mritunjaysharma450-cloud/VISHVAKARMA-AWARDS-VK26-IITH-SC-0177/Maker Journey/WhatsApp Image 2026-10-26 at 10.41.54 PM.jpeg

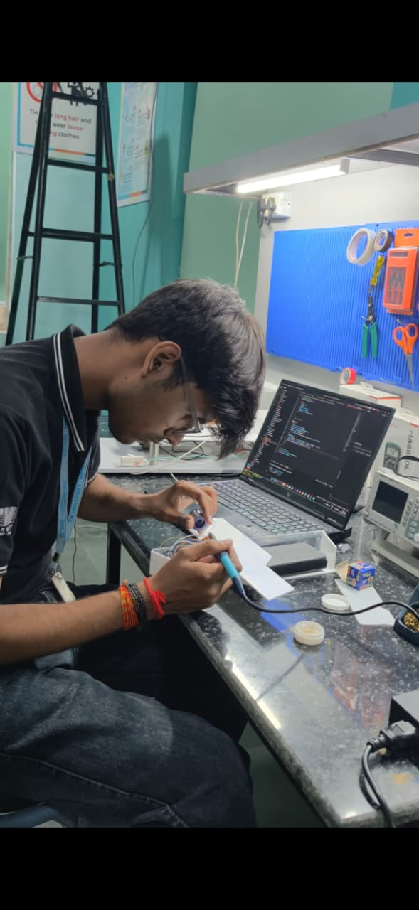
Maker Journey/WhatsApp Image 2026-10-26 at 10.41.54 PM.jpeg
