mritunjaysharma450-cloud/VISHVAKARMA-AWARDS-VK26-IITH-SC-0177/CAD Design & Mechanical Specs/CAD-Design-and-Mechanical-Specs.md

# CAD Design & Mechanical Specs

This section contains design intent only. CAD files are not included
in this version, and FEA has not been performed.

- Pole height, as in the submitted deck: about 2 m, concept stage.
- Pole material, as in the submitted deck: PVC / GI under consideration.
  No material is claimed as selected, and no material property is
  claimed as tested.
- Enclosures: to be made after measuring components and PCB, as in
  the deck. No enclosure design is presented here.
- CAD files: the deck states "CAD file will be updated later in the
  github repo". That update has not been made yet. This folder is
  therefore a placeholder for CAD work, not a CAD delivery, and it
  contains no CAD renders, exploded views, or STEP / SLDPRT files.
- FEA / stress analysis: NOT performed. No FEA plot, mesh statistic,
  convergence result, or load-bearing calculation is presented here.
- Mechanical validation: none performed yet. Bench and closed-course
  mechanical testing is Stage 3 work, as in the roadmap.

The institution template asks for 3D renders, material selection, and
FEA. The position of this section is: CAD and FEA are pending, the pole
concept is about 2 m, and material is under consideration.
