mritunjaysharma450-cloud/VISHVAKARMA-AWARDS-VK26-IITH-SC-0177/INDEX.md

# Contents

Folder names follow the institution template sections, including "&"
where the template uses it. This repository contains supplementary
technical content that was not in the Stage 2 presentation. Material
already presented in the presentation is not repeated here, and sections
with no supplementary content beyond the presentation are not included
as folders.

| No. | Template section | Folder in this repository | Contents | Note |
|---|---|---|---|---|
| 1 | Project Overview | — | Presented in the Stage 2 presentation | — |
| 2 | Problem Statement | — | Presented in the Stage 2 presentation | — |
| 3 | Problem Context | — | Presented in the Stage 2 presentation | — |
| 4 | User Journey | — | Presented in the Stage 2 presentation | — |
| 5 | System Architecture & Specs | System Architecture & Specs/ | Overall-System-Architecture.md, Pole-Unit-Software-Design-Refined.md, Vehicle-Module-Software-Design-Refined.md | Design only, this design has not been bench-tested |
| 6 | CAD Design & Mechanical Specs | CAD Design & Mechanical Specs/ | CAD-Design-and-Mechanical-Specs.md | CAD files are not included in this version, FEA has not been performed |
| 7 | Electronics Schematics & BOM | Electronics Schematics & BOM/ | Pole Unit Electronic Schematic/ (KiCad source, netlist, ERC), Vehicle Module Electronic Schematic/ (KiCad source, netlist, ERC), BOM-Note.md | Schematics are drafts, Rev A, ERC 0/0/0. BOM update is described in BOM-Note.md |
| 8 | Maker Journey | Maker Journey/ | README.md with photo captions | Joint mentor photo is not included in this version |
| 9 | Safety & Hazard Mitigation | Safety & Hazard Mitigation/ | Safety-and-Failure-Modes.md | Design stage |
| 10 | Roadmap | — | Presented in the Stage 2 presentation | — |
| 11 | Technical Challenges & Risks | Technical Challenges & Risks/ | Technical-Challenges-and-Risks.md, Latency-and-Power-Budgets.md, Test-Protocols.md (results blank), Theoretical-Stress-Testing-16-Scenarios.md | Theory and protocols only |
| 12 | References & Sources | References & Sources/ | Research-Plan.md (52 papers, direct links) | Design research only |

## Dates
- Schematics: made in KiCad 24 October 2026, revised 26 October 2026
  due to component changes.
- Research plan: papers analyzed before submission (Table A, 38) and
  additional literature found 26 October 2026 during submission
  preparation (Table B, 14, NOT prior use).
- All other files in this repository are October 2026 design work, unless
  a file itself states a different date. No dates have been changed.
