mritunjaysharma450-cloud/VISHVAKARMA-AWARDS-VK26-IITH-SC-0177/System Architecture Block Diagram/System Architecture Block Diagram..pdf

# System Architecture Block Diagram

### Digital Zone Mapping | Roadside Radar-UWB Sensing | Connected Vehicle Control

V-ORRA | Intelligent Vehicle Signalling & Connected Road Safety System | VK26-IITH-SC-0177 | Vishwakarma Awards 2026-27 | ITM University Gwalior | 27 October 2026 preparation

### ZONE MAPPING SOFTWARE

F Zone configuration and authorized deployment

## ROADSIDE POLE UNIT

E Electronic controllers | F Firmware / logic | M Mounting | A Power

## SMART VEHICLE UNIT

E Controllers | F Local validation | M Enclosure | A Auxiliary actuation

### 1 Administrator / Traffic Authority

Authorized system operator

Zone Mapping Application

Surveyed road / carriageway geometry NHZ and LBZ polygons; zone IDs Activation policies and coordinates

Configuration Validation
& Versioning

Boundary and policy checks Integrity; version control Authorized deployment

Define zones

Validate / approve

Configuration boundary

Spatial zones and operating policies are deployed to the pole.

Transfer method remains open. Geofence decisions execute on Pi.

Sustainable Cities
Smart Urban Infrastructure & Asset Tracking

### 2 Texas Instruments AWRL6432BOOST

60 GHz FMCW Radar | 57-64 GHz family
Range | Angle | Doppler | Detections
Nominal azimuth FoV ~120 deg; configuration dependent

M Mechanical Structure
& Mounting

~2 m circular pole; top enclosure Adjustable radar / UWB brackets Weighted base; cable routing / support

### 3 Makerfabs MAUWBS3CA1

UWB Anchor - STM32 / DW3000
Tag ID | UWB Range | Timestamp
Single anchor: distance constraint only

Powered USB Hub

4-port USB 3.0 | USB-A upstream
P1 Radar J5 | P2 Anchor USB-UART
P3 Safety gate USB serial
P4 Reserved | Separate 5 V AUX

USB 2.0 / XDS110 Data + Power

USB Serial / UWB Range Reports - hub P2

### Raspberry Pi 5 - Edge Processing Unit

Model B, 1 GB | Local processing and communications

P1 Radar Acquisition

Firmware-defined detections

P2 UWB Acquisition

Tag range / time / validity

Zone Configuration Store

Approved geometry / policies Version and integrity metadata

Authorized Zone Configuration Deployment

USB-A Host

P3 Sensor Calibration & Time Association

Coordinate transforms; mounting offsets; valid / aligned observations

### 4 Vehicle Tracking & Sensor Association

P4 | Multi-frame tracks; radar position vs UWB range
Track-to-tag matching; motion consistency; ambiguity checks

Associated observations

### 5 Confidence-Aware Geofence Decision

P5 | NHZ / LBZ boundary + track position + uncertainty
CONFIRMED_INSIDE_NHZ / _LBZ | CONFIRMED_OUTSIDE
UNKNOWN or ambiguity: no new restrictive command

Track / identity / confidence

P6 Vehicle-Specific Command Proposal

Provisional state only; USB host / hub P3 to safety gate

Proposed state

### 10 Logging & Diagnostics

P8 | Observations; association
Zone / proposal / gate events Applied-state ACK; faults
Side branch; outside control path

Events

P7 Local Network
& MQTT Broker

Pi-hosted 2.4 GHz Wi-Fi AP Mosquitto MQTT broker

Gate + vehicle are Wi-Fi clients. All MQTT traffic uses this broker.

No Pi bypass of gate approval; return ACK / faults to monitoring.

ACK / faults 6 ESP32-S3
Pole Safety Gate

USB serial proposals via hub P3
ARM / DENY; startup DENY
Proposal / association / confidence Session / freshness / watchdog

All authorization checks must pass. Else deny new restrictions. ARM/DENY input: LOW / HIGH Green gate-status LED

USB Serial Proposals /

Diagnostics

Proposal via hub P3

2.4 GHz Wi-Fi / MQTT | Authorized publication; gate status / ACK

Firmware-controlled authorization subsystem

RF LINK A
UWB Two-Way Ranging

IEEE 802.15.4z-compatible
hardware | range evidence No actuation commands

### Makerfabs bare MaUWB tag

Bare UWB tag | regulated 3.3 V
Tag UART | UWB ranging
Tag identity and ranging participation

A 3.3 V Regulator for UWB Tag

Regulated 3.3 V supply for bare tag Local common ground
Implementation per schematic

3.3 V DC

Optional GPS / GNSS

GPS UART, context only
Never a zone authority

### 8 ESP32-S3 Vehicle Controller

ESP32-S3

Wi-Fi / MQTT Client
Command Validation
Vehicle / tag identity and session Independent gate-authorization checks Authenticity / replay / expiry checks Physical override priority

Vehicle State Machine
Lamp HIGH/LOW mode + strobe
Horn coil command + deadman pulse
Tag UART | GPS UART | override sense
Acknowledgements / Diagnostics Local watchdog and safe recovery

Tag UART - 115200 / 8N1
3.3 V logic; matching firmware
Tag TX to controller RX
Controller TX to tag RX
Local common ground GPS UART

RF LINK B

### 2.4 GHz Wi-Fi / MQTT

7 Authenticated Vehicle-Specific MQTT Command

Applied-State ACK
+ Fault Status

Wireless links only
Independent demo supplies
Local grounds; no cable

### 9 Auxiliary Horn Control

Horn deadman timer + MOSFET driver Fresh pulses required for suppression Expiry / fault / link loss: fail-open release Normally-closed relay: horn available when coil power is lost
Auxiliary demo sounder + horn button

Coil + pulse

Status & Diagnostics

Status indicators | diagnostic alerts
Horn-button sense | applied state / faults

### 9 Auxiliary Lighting Control

Lamp mode latch + MOSFET driver HIGH/LOW auxiliary demo lamp Holds mode on stale / unknown data FREEZE; no automatic HIGH on uncertainty

Mode/strobe

M Mechanical Structure & Mounting

Compact electronics enclosure with mounting provision Secure controller / tag / demo outputs and local cable routing

A Physical Override

Rail cut + relay bypass; wins if firmware hangs Manual HIGH/LOW selection; override sense

A POLE POWER - separate regulated supplies

100 W / 156 Wh

Portable Power Station

Rated AC Extension

Purchased AC connections

AC | Official Raspberry Pi 27 W USB-C Supply

Regulated Adapter

### 5.1 V DC / 5 A to Pi USB-C

Regulated DC to Hub AUX

Active Cooler: official Pi fan connector

A VEHICLE POWER - independent supply / local common GND

Independent Demo

Power Supply

Fuse + Master Switch

Switched demo supply

Demo Power Distribution

Controller | UWB regulator | optional GPS
Auxiliary horn path | physical override input
Override gates actuation; local ground
CONTROL PRINCIPLES | Ambiguous position / identity: no new restriction. | Expired horn authorization: release suppression.
Uncertain lighting: no automatic HIGH. | Physical override has priority. | Auxiliary demo only; closed-course only.
Independent demo supplies; local grounds only; no pole-to-vehicle cable or wiring into real vehicle horn / headlamp circuits.
LINE CONVENTIONS | Arrow direction indicates sender to receiver; matching named power nets are continuous locally.
Wired / logical data | Wireless RF | Power / voltage | Configuration | Inhibit / output control
M Mechanical structure | A Actuation & power | E Electronic controllers | F Firmware & logic | Dashed box: optional feature | SHEET 01 / 03
