mritunjaysharma450-cloud/VISHVAKARMA-AWARDS-VK26-IITH-SC-0177/Maker Journey/IMG_20261023_164714.jpg.jpeg

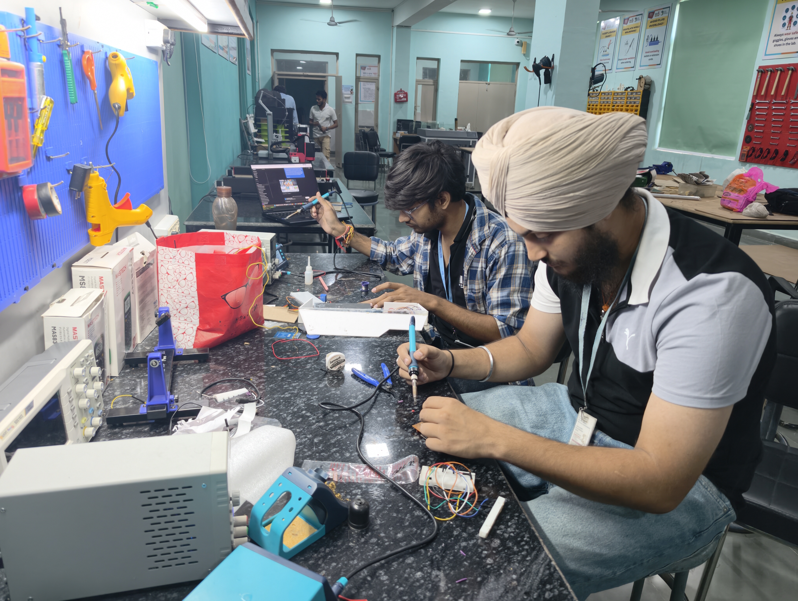
Maker Journey/IMG_20261023_164714.jpg.jpeg
