mritunjaysharma450-cloud/VISHVAKARMA-AWARDS-VK26-IITH-SC-0177/Electronics Schematics & BOM/Vehicle Module Electronic Schematic/Vehicle_Module_Electronic_Schematic.pdf

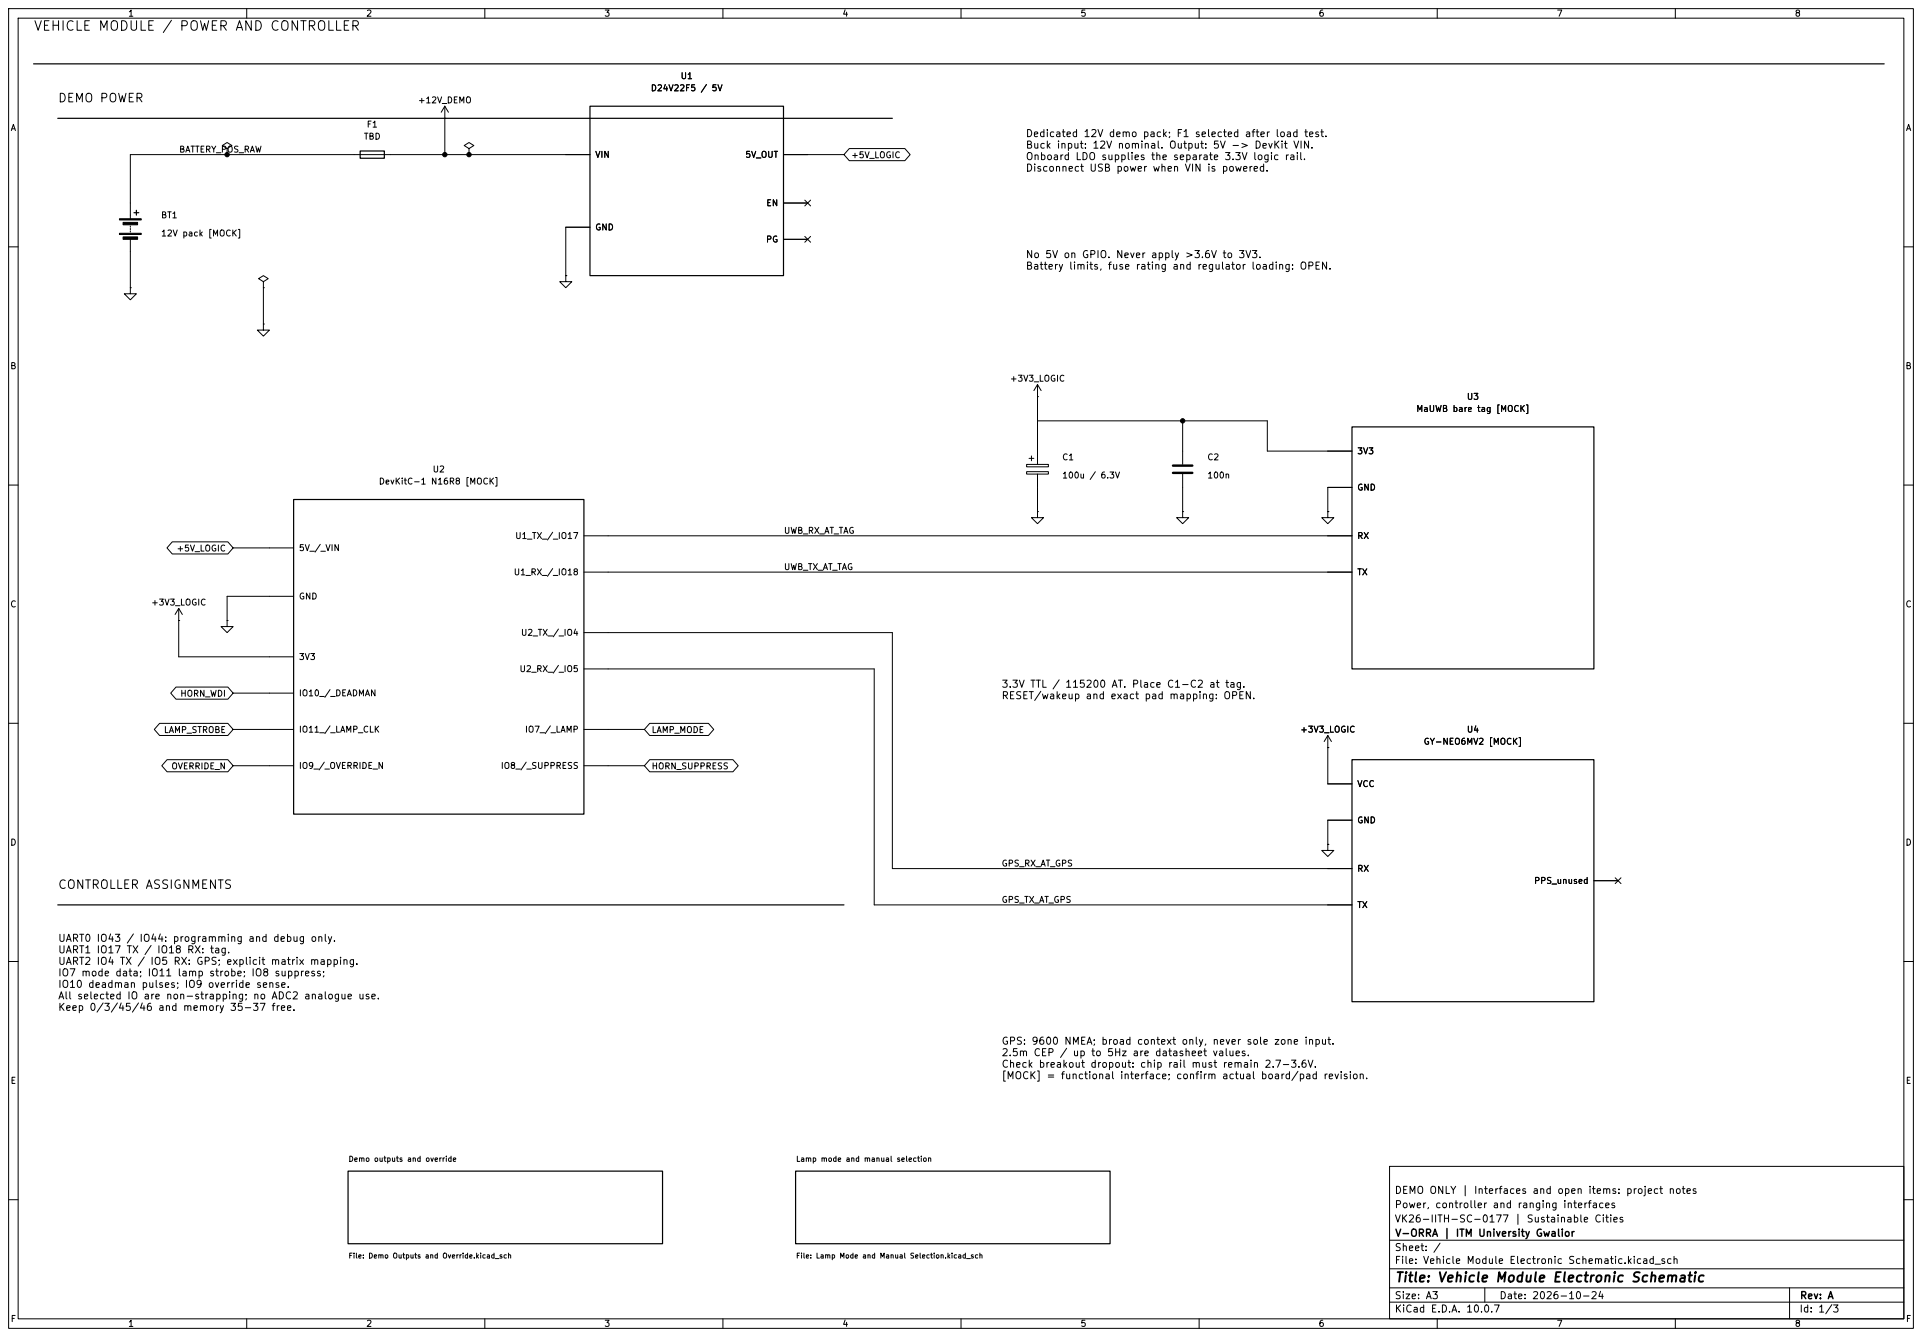
[picture p9: page 1]

VEHICLE MODULE / POWER AND CONTROLLER

Buck input: 12V nominal. Output: 5V -> DevKit VIN.
Onboard LDO supplies the separate 3.3V logic rail.
Disconnect USB power when VIN is powered.

No 5V on GPIO. Never apply >3.6V to 3V3.
Battery limits, fuse rating and regulator loading: OPEN.

3.3V TTL / 115200 AT. Place C1-C2 at tag.
RESET/wakeup and exact pad mapping: OPEN.

UART0 IO43 / IO44: programming and debug only.
UART1 IO17 TX / IO18 RX: tag.
UART2 IO4 TX / IO5 RX: GPS; explicit matrix mapping.
IO7 mode data; IO11 lamp strobe; IO8 suppress;
IO10 deadman pulses; IO9 override sense. All selected IO are non-strapping; no ADC2 analogue use. Keep 0/3/45/46 and memory 35-37 free.

GPS: 9600 NMEA; broad context only, never sole zone input.
2.5m CEP / up to 5Hz are datasheet values.
Check breakout dropout: chip rail must remain 2.7-3.6V.
[MOCK] = functional interface; confirm actual board/pad revision.

Demo outputs and override

Lamp mode and manual selection

DEMO ONLY | Interfaces and open items: project notes
Power, controller and ranging interfaces
VK26-IITH-SC-0177 | Sustainable Cities
V-ORRA | ITM University Gwalior
Sheet: /
File: Vehicle Module Electronic Schematic.kicad_sch
Title: Vehicle Module Electronic Schematic

File: Demo Outputs and Override.kicad_sch

File: Lamp Mode and Manual Selection.kicad_sch

Size: A3 | Rev: A | F Date: 2026-10-24
KiCad E.D.A. 10.0.7 | Id: 1/3

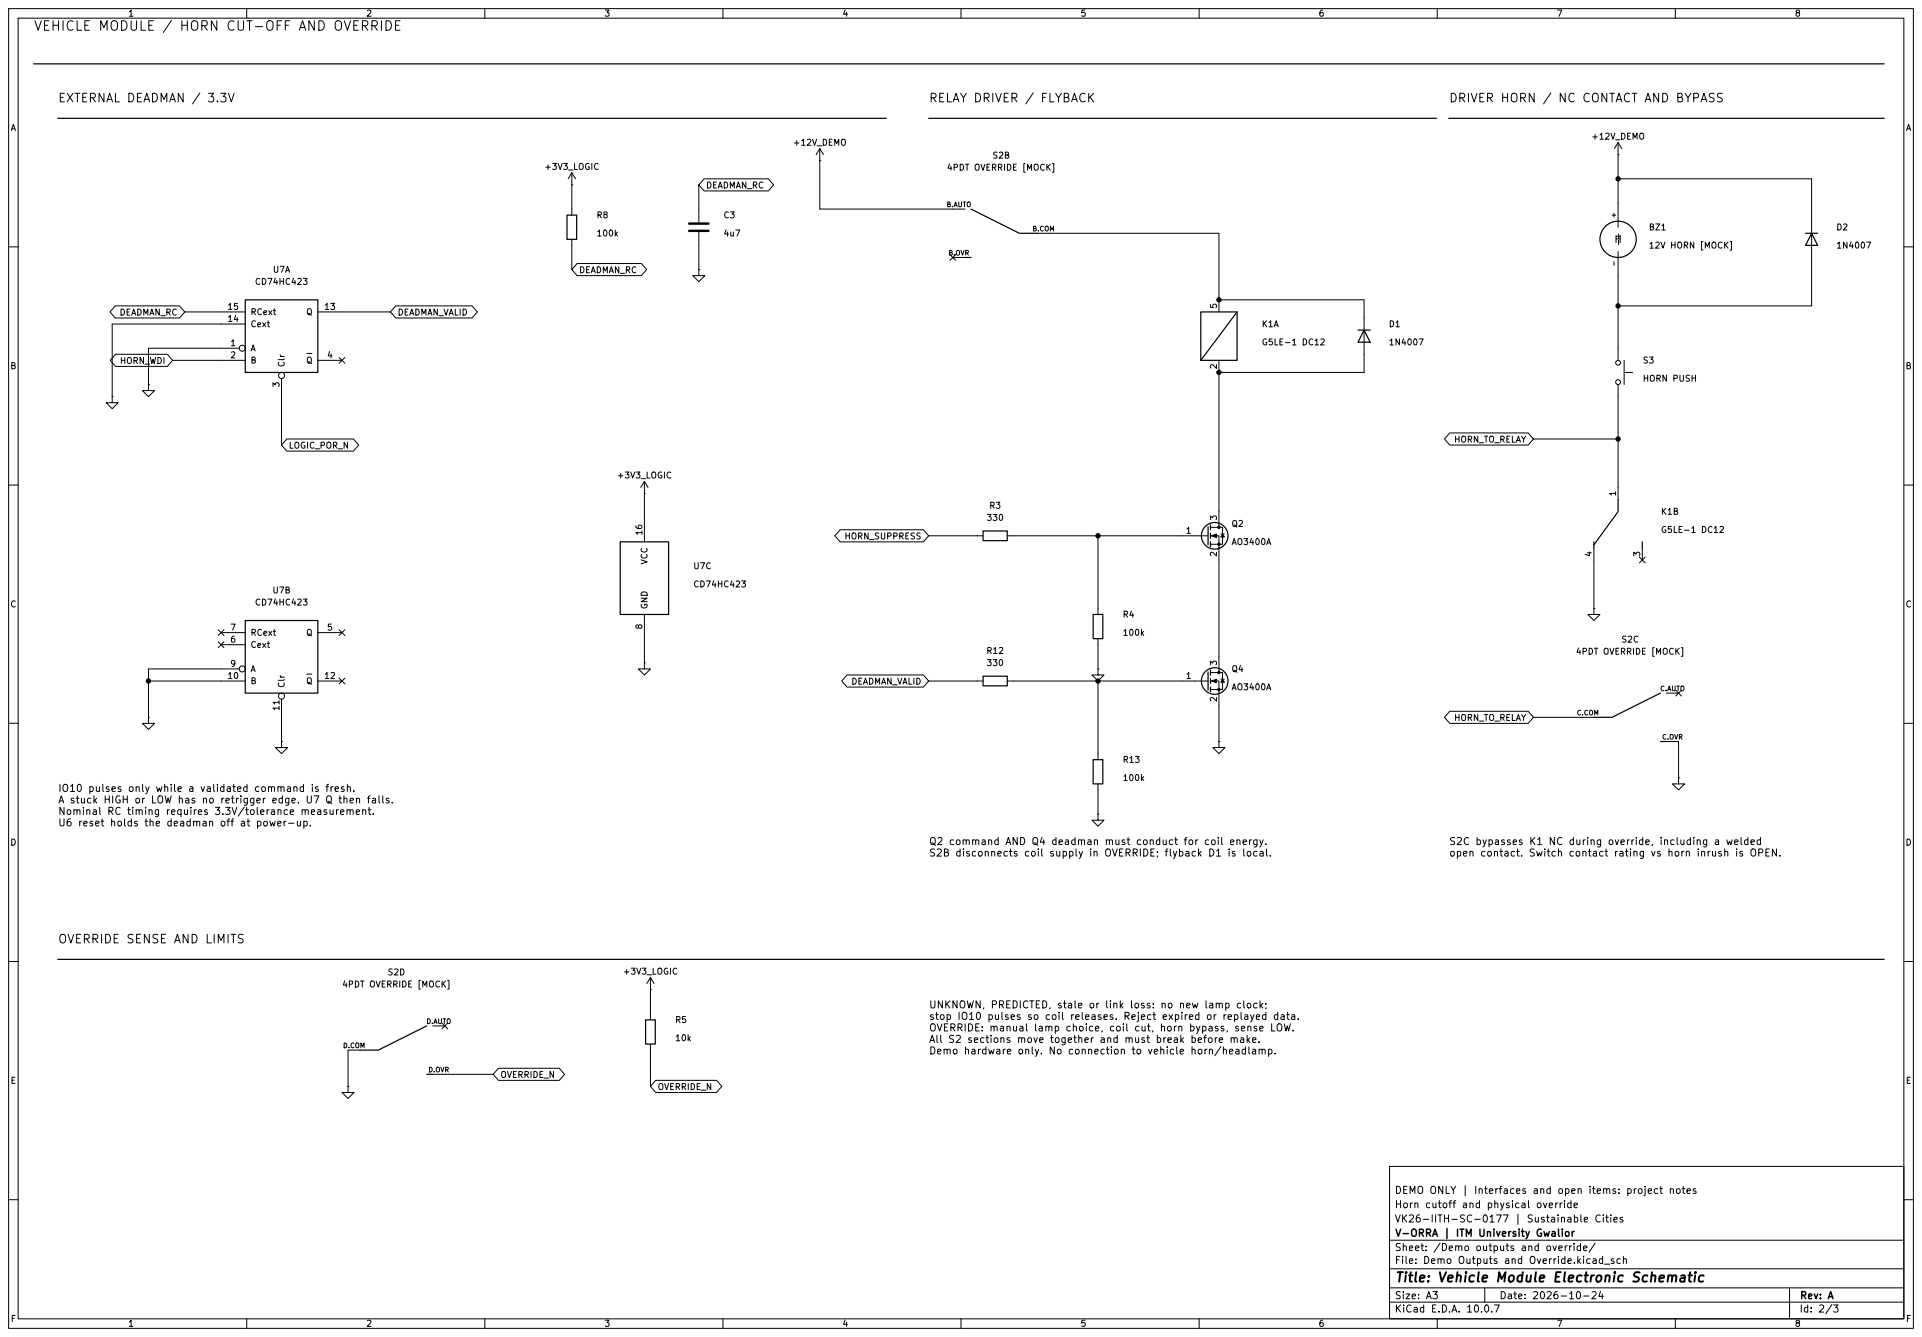
[picture p10: page 2]

VEHICLE MODULE / HORN CUT-OFF AND OVERRIDE

DRIVER HORN / NC CONTACT AND BYPASS

IO10 pulses only while a validated command is fresh.
A stuck HIGH or LOW has no retrigger edge. U7 Q then falls.
Nominal RC timing requires 3.3V/tolerance measurement.
U6 reset holds the deadman off at power-up.

Q2 command AND Q4 deadman must conduct for coil energy.
S2B disconnects coil supply in OVERRIDE; flyback D1 is local.

S2C bypasses K1 NC during override, including a welded
open contact. Switch contact rating vs horn inrush is OPEN.

UNKNOWN, PREDICTED, stale or link loss: no new lamp clock;
stop IO10 pulses so coil releases. Reject expired or replayed data.
OVERRIDE: manual lamp choice, coil cut, horn bypass, sense LOW.
All S2 sections move together and must break before make.
Demo hardware only. No connection to vehicle horn/headlamp.

DEMO ONLY | Interfaces and open items: project notes
Horn cutoff and physical override
VK26-IITH-SC-0177 | Sustainable Cities
V-ORRA | ITM University Gwalior
Sheet: /Demo outputs and override/
File: Demo Outputs and Override.kicad_sch

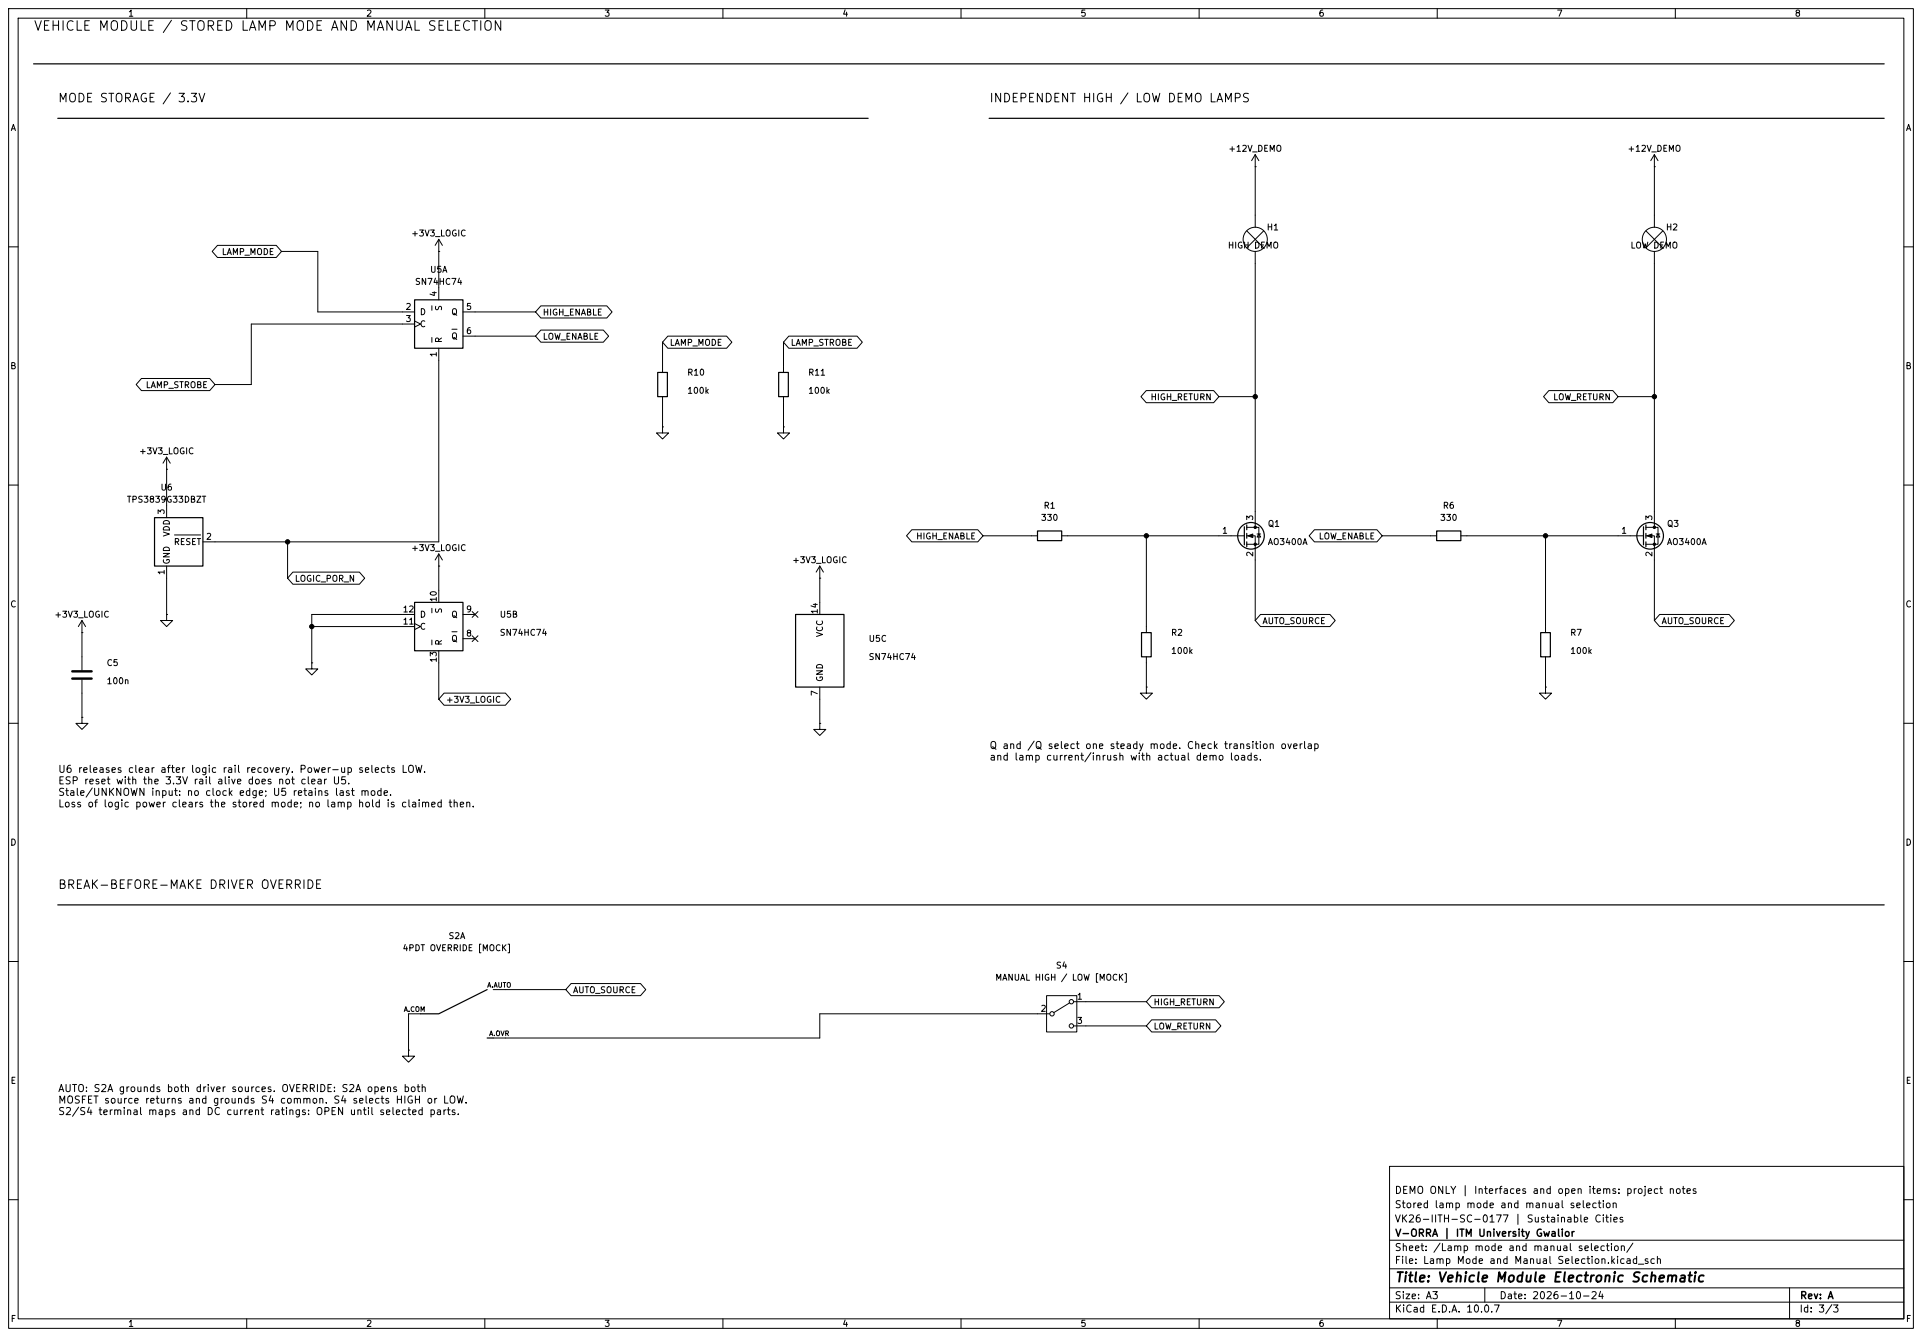
[picture p11: page 3]

VEHICLE MODULE / STORED LAMP MODE AND MANUAL SELECTION

AUTO_SOURCE U6 releases clear after logic rail recovery. Power-up selects LOW.

Q and /Q select one steady mode. Check transition overlap
and lamp current/inrush with actual demo loads.

ESP reset with the 3.3V rail alive does not clear U5.
Stale/UNKNOWN input: no clock edge; U5 retains last mode.
Loss of logic power clears the stored mode; no lamp hold is claimed then.

BREAK-BEFORE-MAKE DRIVER OVERRIDE

S4 MANUAL HIGH / LOW [MOCK]

AUTO: S2A grounds both driver sources. OVERRIDE: S2A opens both
MOSFET source returns and grounds S4 common. S4 selects HIGH or LOW.
S2/S4 terminal maps and DC current ratings: OPEN until selected parts.

DEMO ONLY | Interfaces and open items: project notes
Stored lamp mode and manual selection
VK26-IITH-SC-0177 | Sustainable Cities
V-ORRA | ITM University Gwalior
Sheet: /Lamp mode and manual selection/
File: Lamp Mode and Manual Selection.kicad_sch
