mritunjaysharma450-cloud/VISHVAKARMA-AWARDS-VK26-IITH-SC-0177/Electronics Schematics & BOM/Pole Unit Electronic Schematic/Pole_Unit_Electronic_Schematic.pdf

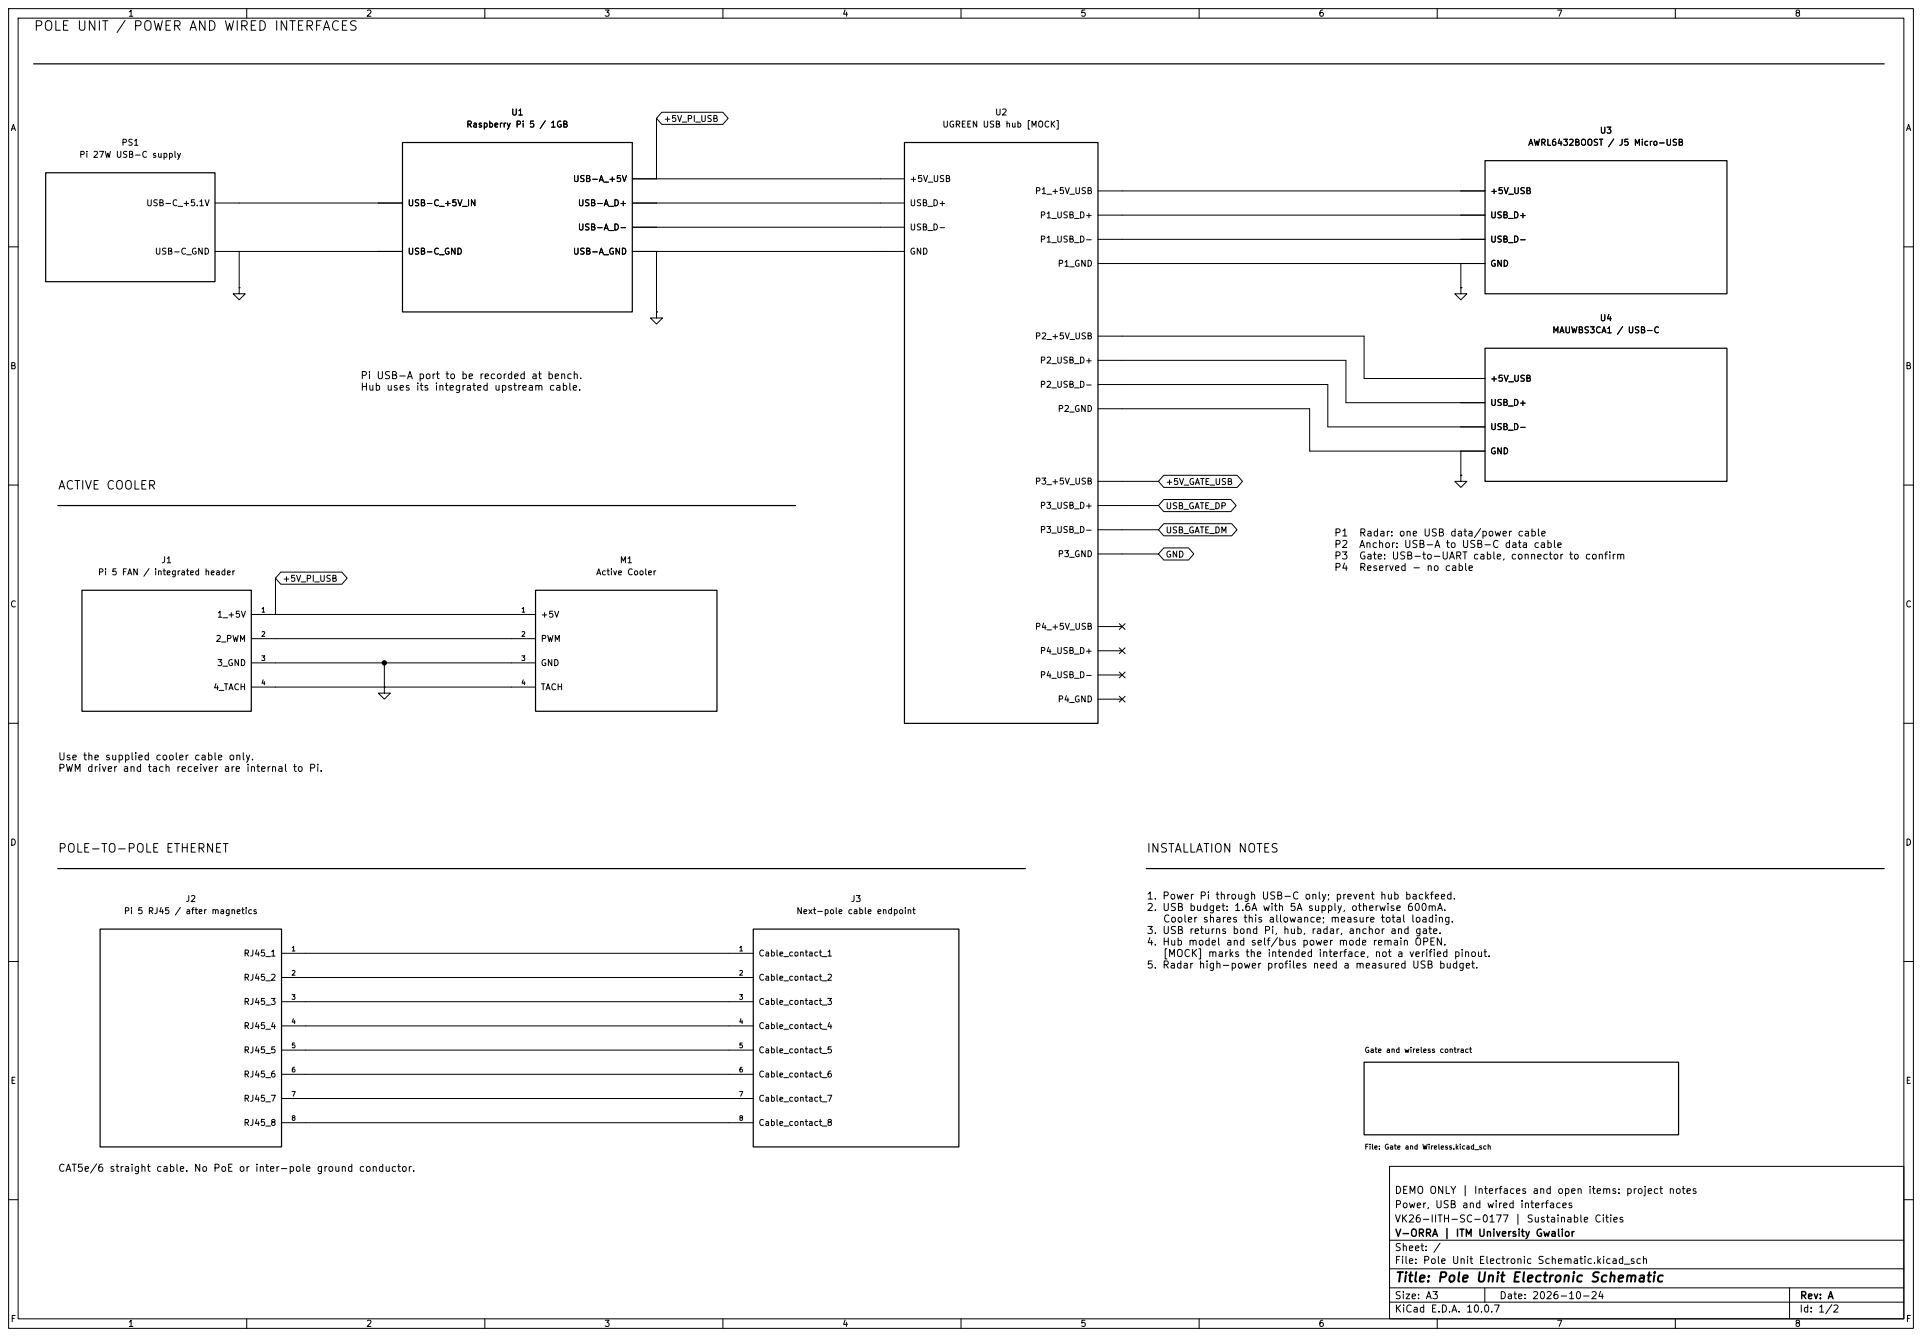
[picture p12: page 1]

POLE UNIT / POWER AND WIRED INTERFACES

GND +5V_USB U1 Raspberry Pi 5 / 1GB USB-A_D-

USB-A_GND USB-A_+5V USB-C_GND USB-C_+5V_IN

Pi USB-A port to be recorded at bench.
Hub uses its integrated upstream cable.

P1 Radar: one USB data/power cable
P2 Anchor: USB-A to USB-C data cable
P3 Gate: USB-to-UART cable, connector to confirm
P4 Reserved - no cable

Use the supplied cooler cable only.
PWM driver and tach receiver are internal to Pi.

POLE-TO-POLE ETHERNET

1. Power Pi through USB-C only; prevent hub backfeed.
2. USB budget: 1.6A with 5A supply, otherwise 600mA.
Cooler shares this allowance; measure total loading.
3. USB returns bond Pi, hub, radar, anchor and gate.
4. Hub model and self/bus power mode remain OPEN.
[MOCK] marks the intended interface, not a verified pinout.
5. Radar high-power profiles need a measured USB budget.

CAT5e/6 straight cable. No PoE or inter-pole ground conductor.

DEMO ONLY | Interfaces and open items: project notes
Power, USB and wired interfaces
VK26-IITH-SC-0177 | Sustainable Cities
V-ORRA | ITM University Gwalior
Sheet: /
File: Pole Unit Electronic Schematic.kicad_sch
Title: Pole Unit Electronic Schematic

Size: A3 | Rev: A | F Date: 2026-10-24
KiCad E.D.A. 10.0.7 | Id: 1/2

1 | 2 | 3 | 4 | 5 | 6 | 7 | 8

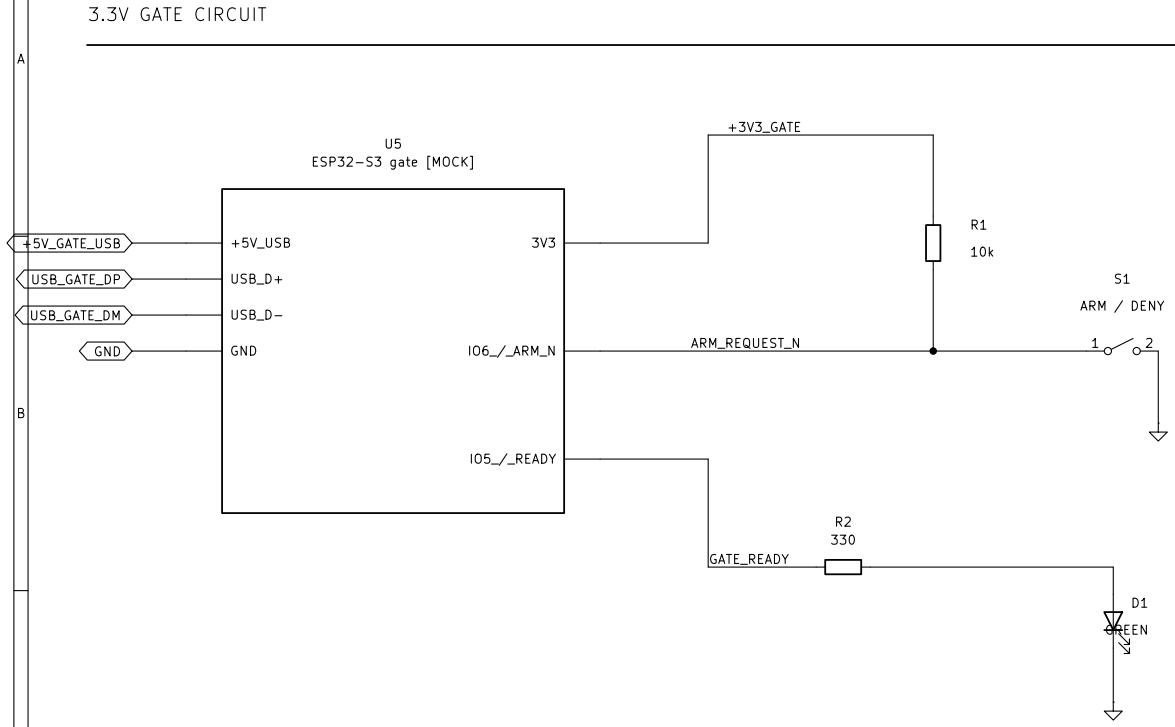
[picture p13: figure]
ARM / DENY 3V3 USB_D-; USB_D+; GND; IO5_/_READY; IO6_/_ARM_N +5V_USB; ESP32-S3 gate [MOCK]; D1 GREEN +5V_GATE_USB USB_GATE_DP USB_GATE_DM; +3V3_GATE; ARM_REQUEST_N; 3.3V GATE CIRCUIT

1 | 2 | 3 | 4 | 5 | 6 | 7 | 8

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
Size: A3 | Rev: A | F Date: 2026-10-24
KiCad E.D.A. 10.0.7 | Id: 2/2

### Title: Pole Unit Electronic Schematic

File: Gate and Wireless.kicad_sch

Sheet: /Gate and wireless contract/

V-ORRA | ITM University Gwalior
VK26-IITH-SC-0177 | Sustainable Cities

Gate, wireless links and command interlock

DEMO ONLY | Interfaces and open items: project notes

GATE_READY S1 maintained: closed = ARM request; open/broken = DENY.

Startup state: DENY. A short to GND is not detected here. USB powers the board; no 5V connection to IO5 or IO6.

PROPOSED PROTOCOL - implementation and injection test pending. Pi sends candidate over USB; gate makes a second decision.
Gate publishes vorra/v1/vehicles/<id>/commands via Wi-Fi.
Pi owns sequence; gate preserves it and signs the full payload. Vehicle checks gate signature, ID, session, epoch, sequence, expiry. ACL blocks Pi-app writes to commands; key stays on gate/vehicle. Gate shares Pi power, AP and broker: decision independence only. DENY, malformed input or watchdog expiry: no fresh publish.

WIRELESS LINKS - LOGICAL ONLY

### POLE UNIT / SAFETY GATE AND RADIO LINKS

Pi 5 / Wi-Fi AP + Mosquitto

2.4 GHz Wi-Fi / MQTT

UNKNOWN, PREDICTED, stale or link loss: lamp HOLDS; horn suppression RELEASES (fail-open).
Reject expired, duplicate, retained and replayed commands. Prediction never overrides fail-open.
Physical driver override takes electrical priority and is logged. Demo hardware only; no vehicle wiring. Radar: 57-64 GHz, 2 TX / 3 RX, 120 deg azimuth / 80 deg elevation. Multiple XDS110 ports use one cable. No cameras, video, faces, number plates, immobilisation or V-Gun actuation. Closed-course demo only.

Vehicle client

Vehicle MaUWB tag

UWB CH5 6489.6 MHz / two-way ranging only

Surveyed road / vehicle

DEMO SAFETY / OPERATING NOTES

COMMAND INTERLOCK | 60 GHz sensing / aim antenna face at road

Gate client

MAUWBS3CA1 anchor

AWRL6432BOOST
