mritunjaysharma450-cloud/VISHVAKARMA-AWARDS-VK26-IITH-SC-0177/Electronics Schematics & BOM/Pole Unit Electronic Schematic/Gate_and_Wireless.kicad_sch

## KiCad design Electronics Schematics & BOM/Pole Unit Electronic Schematic/Gate_and_Wireless.kicad_sch (2026-10-26)

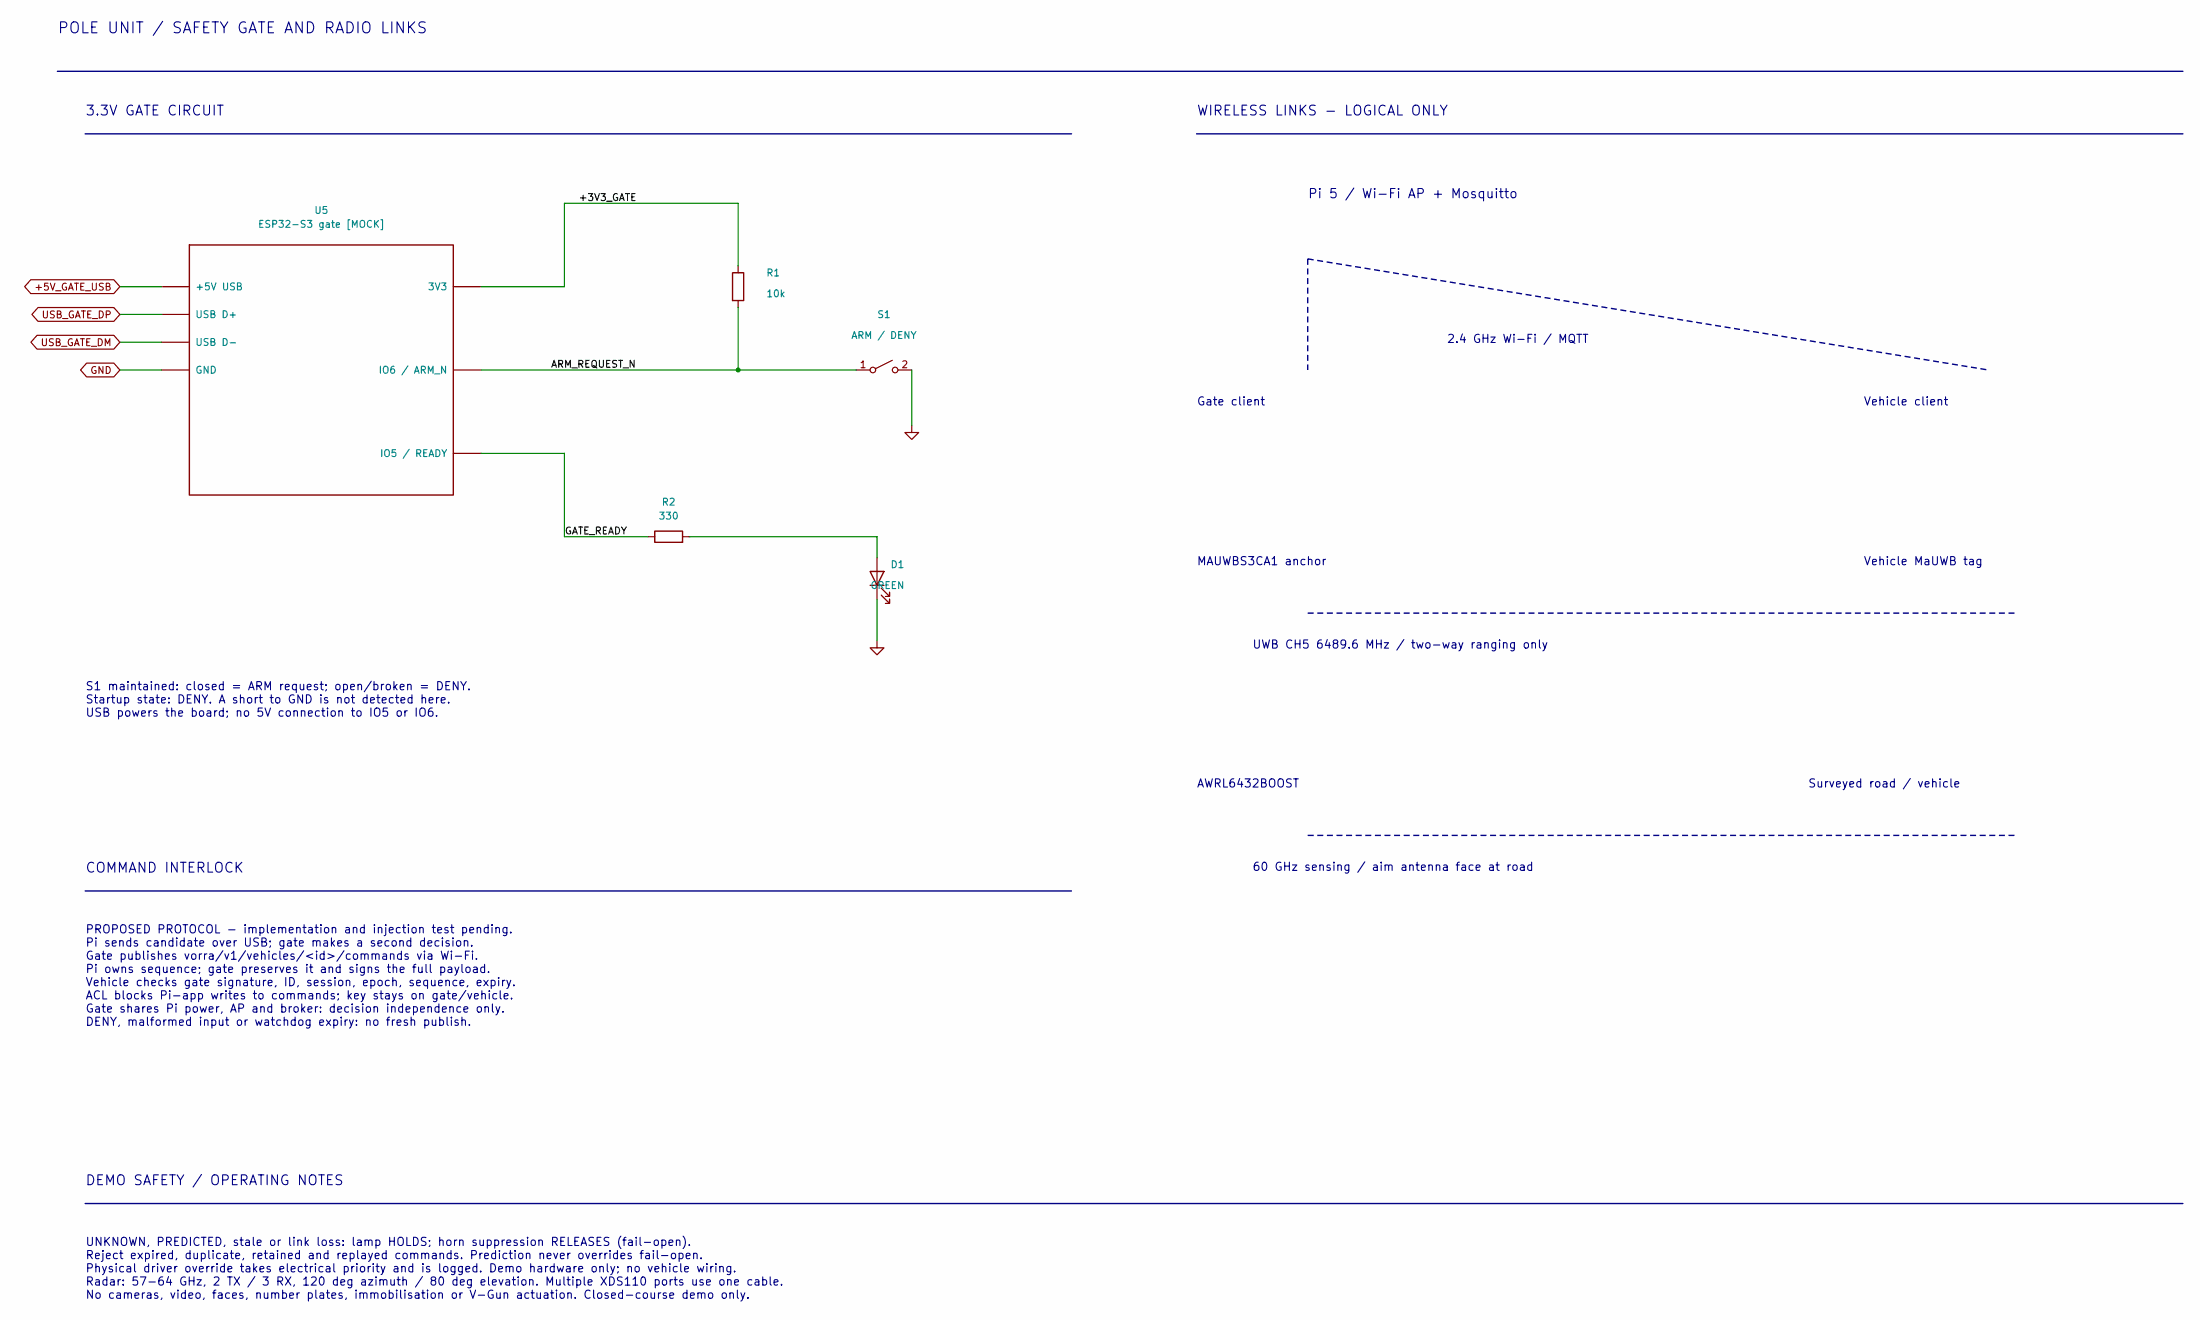
[picture p14: schematic Gate_and_Wireless.kicad_sch]

Parts:
D1: GREEN
R1: 10k
R2: 330
S1: ARM / DENY
U5: ESP32-S3 gate [MOCK]

Connections:
+3V3_GATE: R1.1, U5.3V3
+5V_GATE_USB: U5.VBUS (+5V USB)
ARM_REQUEST_N: R1.2, S1.1 (A), U5.GPIO6 (IO6 / ARM_N)
GATE_READY: R2.1, U5.GPIO5 (IO5 / READY)
GND: D1.1 (K), S1.2 (B), U5.GND
unnamed: D1.2 (A), R2.2
USB_GATE_DM: U5.DM (USB D-)
USB_GATE_DP: U5.DP (USB D+)

Notes on the sheet:
POLE UNIT / SAFETY GATE AND RADIO LINKS
3.3V GATE CIRCUIT
S1 maintained: closed = ARM request; open/broken = DENY. Startup state: DENY. A short to GND is not detected here. USB powers the board; no 5V connection to IO5 or IO6.
WIRELESS LINKS - LOGICAL ONLY
Pi 5 / Wi-Fi AP + Mosquitto
Gate client
Vehicle client
2.4 GHz Wi-Fi / MQTT
MAUWBS3CA1 anchor
Vehicle MaUWB tag
UWB CH5 6489.6 MHz / two-way ranging only
AWRL6432BOOST
Surveyed road / vehicle
60 GHz sensing / aim antenna face at road
COMMAND INTERLOCK
PROPOSED PROTOCOL - implementation and injection test pending. Pi sends candidate over USB; gate makes a second decision. Gate publishes vorra/v1/vehicles/<id>/commands via Wi-Fi. Pi owns sequence; gate preserves it and signs the full payload. Vehicle checks gate signature, ID, session, epoch, sequ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
DEMO SAFETY / OPERATING NOTES
UNKNOWN, PREDICTED, stale or link loss: lamp HOLDS; horn suppression RELEASES (fail-open). Reject expired, duplicate, retained and replayed commands. Prediction never overrides fail-open. Physical driver override takes electrical priority and is logged. Demo hardware only; no vehicle wiring. Radar: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
