mritunjaysharma450-cloud/VISHVAKARMA-AWARDS-VK26-IITH-SC-0177/Electronics Schematics & BOM/Pole Unit Electronic Schematic/Pole_Unit_Electronic_Schematic.kicad_sch

## KiCad design Electronics Schematics & BOM/Pole Unit Electronic Schematic/Pole_Unit_Electronic_Schematic.kicad_sch (2026-10-26)

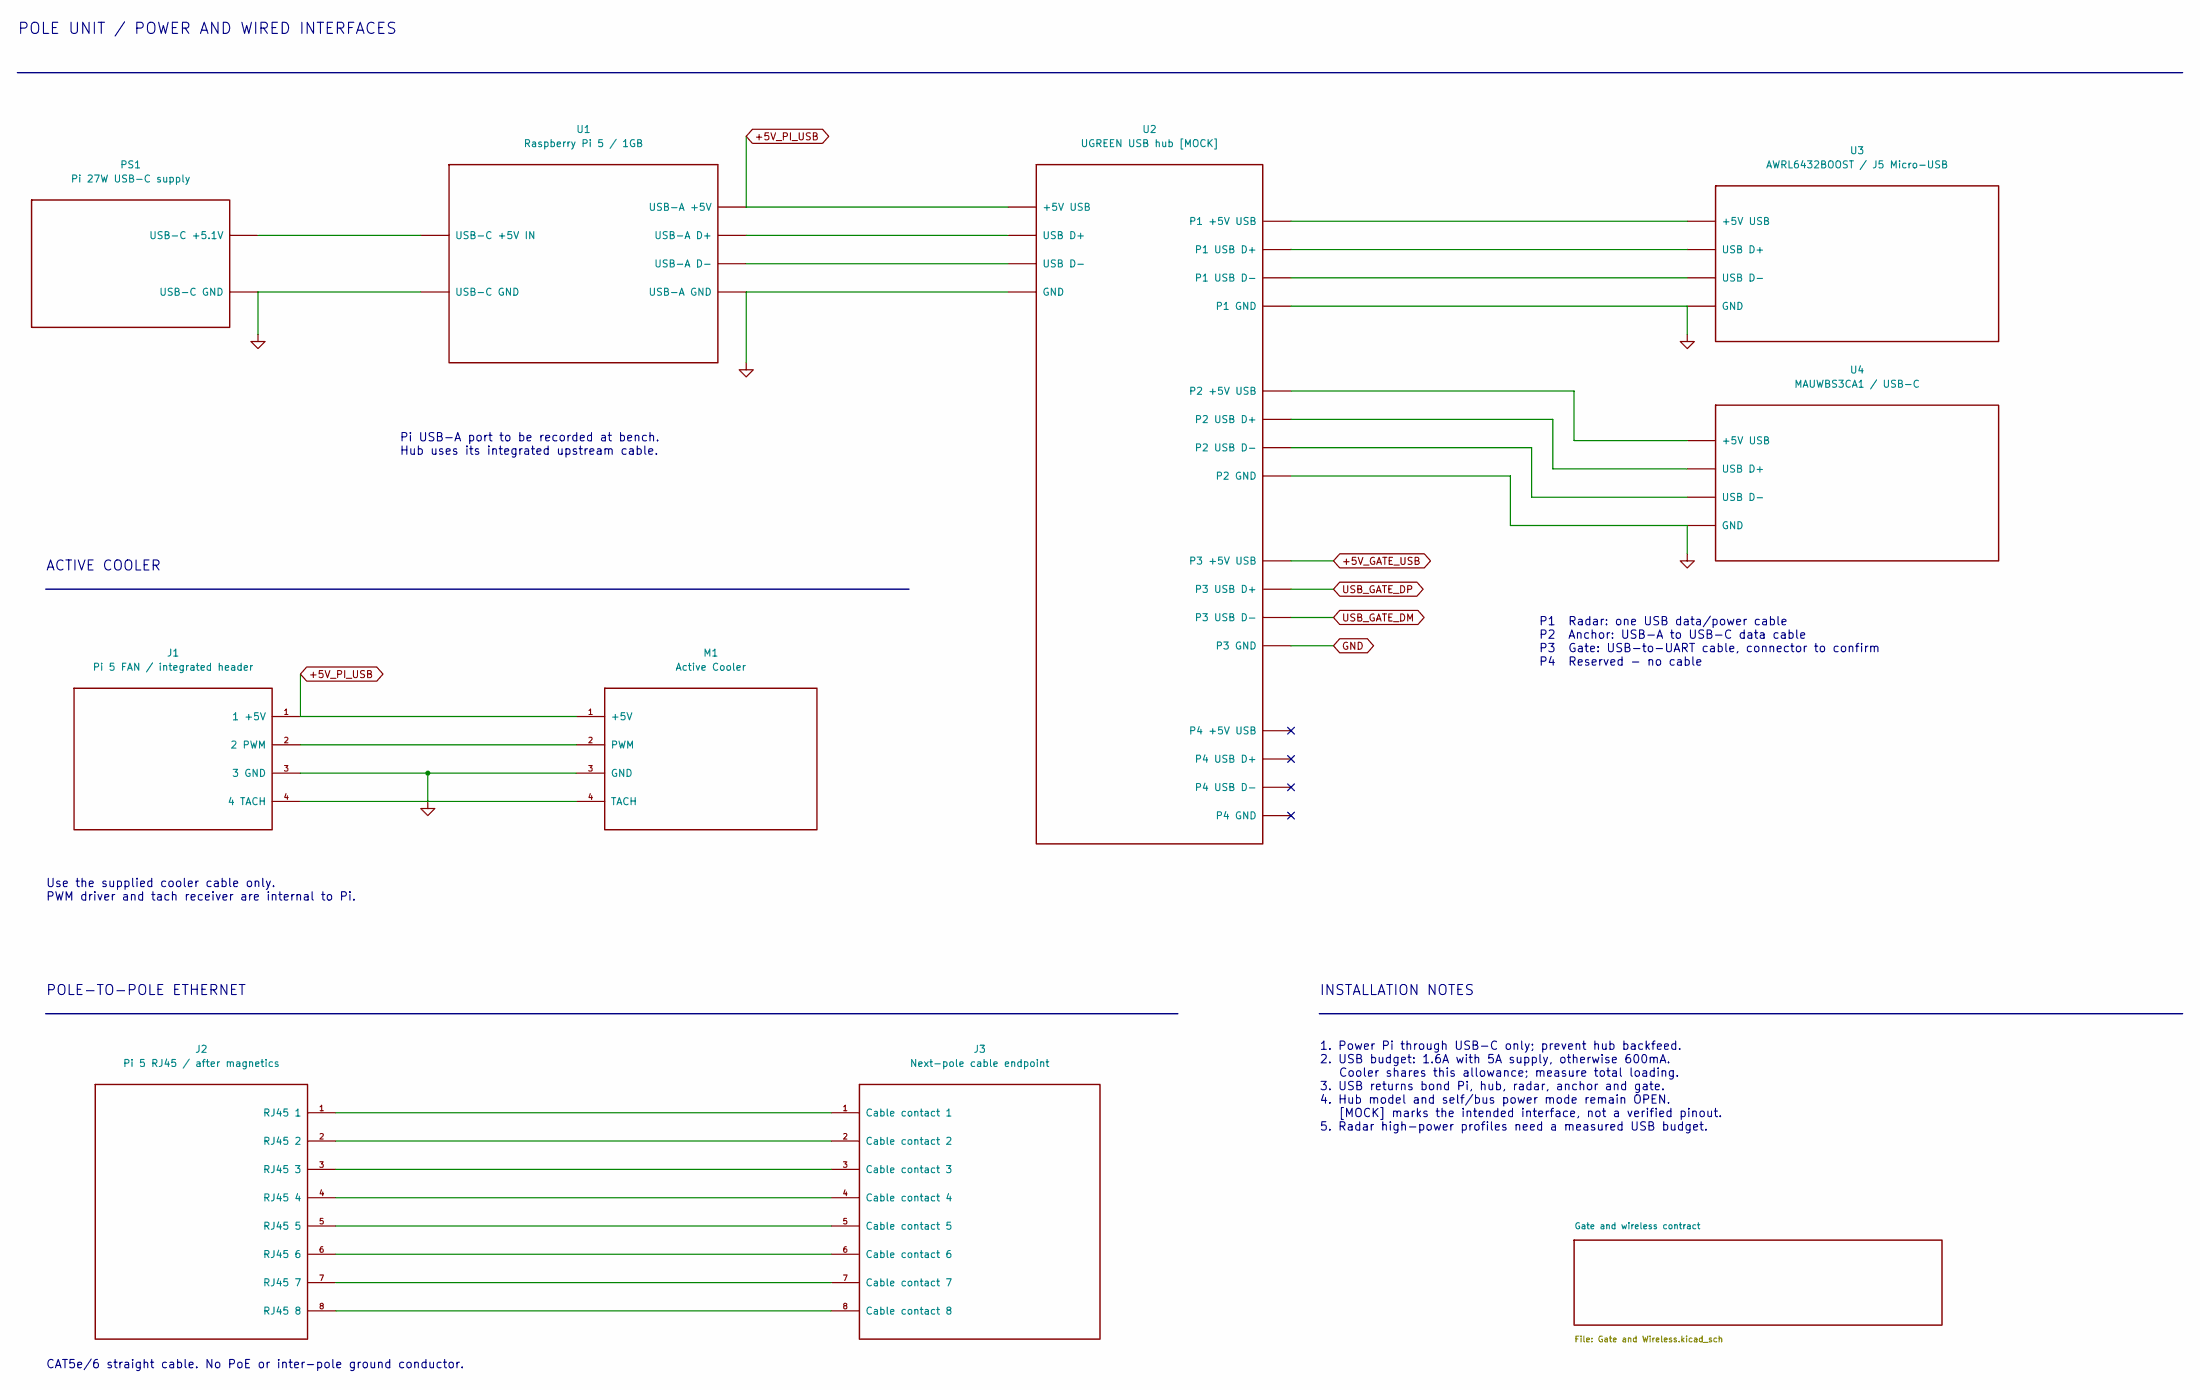
[picture p15: schematic Pole_Unit_Electronic_Schematic.kicad_sch]

Parts:
J1: Pi 5 FAN / integrated header
J2: Pi 5 RJ45 / after magnetics
J3: Next-pole cable endpoint
M1: Active Cooler
PS1: Pi 27W USB-C supply
U1: Raspberry Pi 5 / 1GB
U2: UGREEN USB hub [MOCK]
U3: AWRL6432BOOST / J5 Micro-USB
U4: MAUWBS3CA1 / USB-C

Connections:
+5V_GATE_USB: U2.P3.VBUS (P3 +5V USB)
+5V_PI_USB: J1.1 (1 +5V), M1.1 (+5V), U1.HOST.VBUS (USB-A +5V), U2.VBUS (+5V USB)
GND: J1.3 (3 GND), J1.4 (4 TACH), M1.3 (GND), M1.4 (TACH), PS1.GND (USB-C GND), U1.HOST.GND (USB-A GND), U1.PWR.GND (USB-C GND), U2.GND, U2.P1.GND (P1 GND), U2.P2.GND (P2 GND), U2.P3.GND (P3 GND), U3.GND, U4.GND
unnamed: J1.2 (2 PWM), M1.2 (PWM)
unnamed: J2.1 (RJ45 1), J3.1 (Cable contact 1)
unnamed: J2.2 (RJ45 2), J3.2 (Cable contact 2)
unnamed: J2.3 (RJ45 3), J3.3 (Cable contact 3)
unnamed: J2.4 (RJ45 4), J3.4 (Cable contact 4)
unnamed: J2.5 (RJ45 5), J3.5 (Cable contact 5)
unnamed: J2.6 (RJ45 6), J3.6 (Cable contact 6)
unnamed: J2.7 (RJ45 7), J3.7 (Cable contact 7)
unnamed: J2.8 (RJ45 8), J3.8 (Cable contact 8)
unnamed: PS1.VBUS (USB-C +5.1V), U1.PWR.VBUS (USB-C +5V IN)
unnamed: U1.HOST.DM (USB-A D-), U2.DM (USB D-)
unnamed: U1.HOST.DP (USB-A D+), U2.DP (USB D+)
unnamed: U2.P1.DM (P1 USB D-), U3.DM (USB D-)
unnamed: U2.P1.DP (P1 USB D+), U3.DP (USB D+)
unnamed: U2.P1.VBUS (P1 +5V USB), U3.VBUS (+5V USB)
unnamed: U2.P2.DM (P2 USB D-), U4.DM (USB D-)
unnamed: U2.P2.DP (P2 USB D+), U4.DP (USB D+)
unnamed: U2.P2.VBUS (P2 +5V USB), U4.VBUS (+5V USB)
USB_GATE_DM: U2.P3.DM (P3 USB D-)
USB_GATE_DP: U2.P3.DP (P3 USB D+)

Notes on the sheet:
POLE UNIT / POWER AND WIRED INTERFACES
P1 Radar: one USB data/power cable P2 Anchor: USB-A to USB-C data cable P3 Gate: USB-to-UART cable, connector to confirm P4 Reserved - no cable
Pi USB-A port to be recorded at bench. Hub uses its integrated upstream cable.
ACTIVE COOLER
Use the supplied cooler cable only. PWM driver and tach receiver are internal to Pi.
POLE-TO-POLE ETHERNET
CAT5e/6 straight cable. No PoE or inter-pole ground conductor.
INSTALLATION NOTES
1. Power Pi through USB-C only; prevent hub backfeed. 2. USB budget: 1.6A with 5A supply, otherwise 600mA. Cooler shares this allowance; measure total loading. 3. USB returns bond Pi, hub, radar, anchor and gate. 4. Hub model and self/bus power mode remain OPEN. [MOCK] marks the intended interface,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
