mritunjaysharma450-cloud/VISHVAKARMA-AWARDS-VK26-IITH-SC-0177/Electronics Schematics & BOM/Vehicle Module Electronic Schematic/Demo_Outputs_and_Override.kicad_sch

## KiCad design Electronics Schematics & BOM/Vehicle Module Electronic Schematic/Demo_Outputs_and_Override.kicad_sch (2026-10-26)

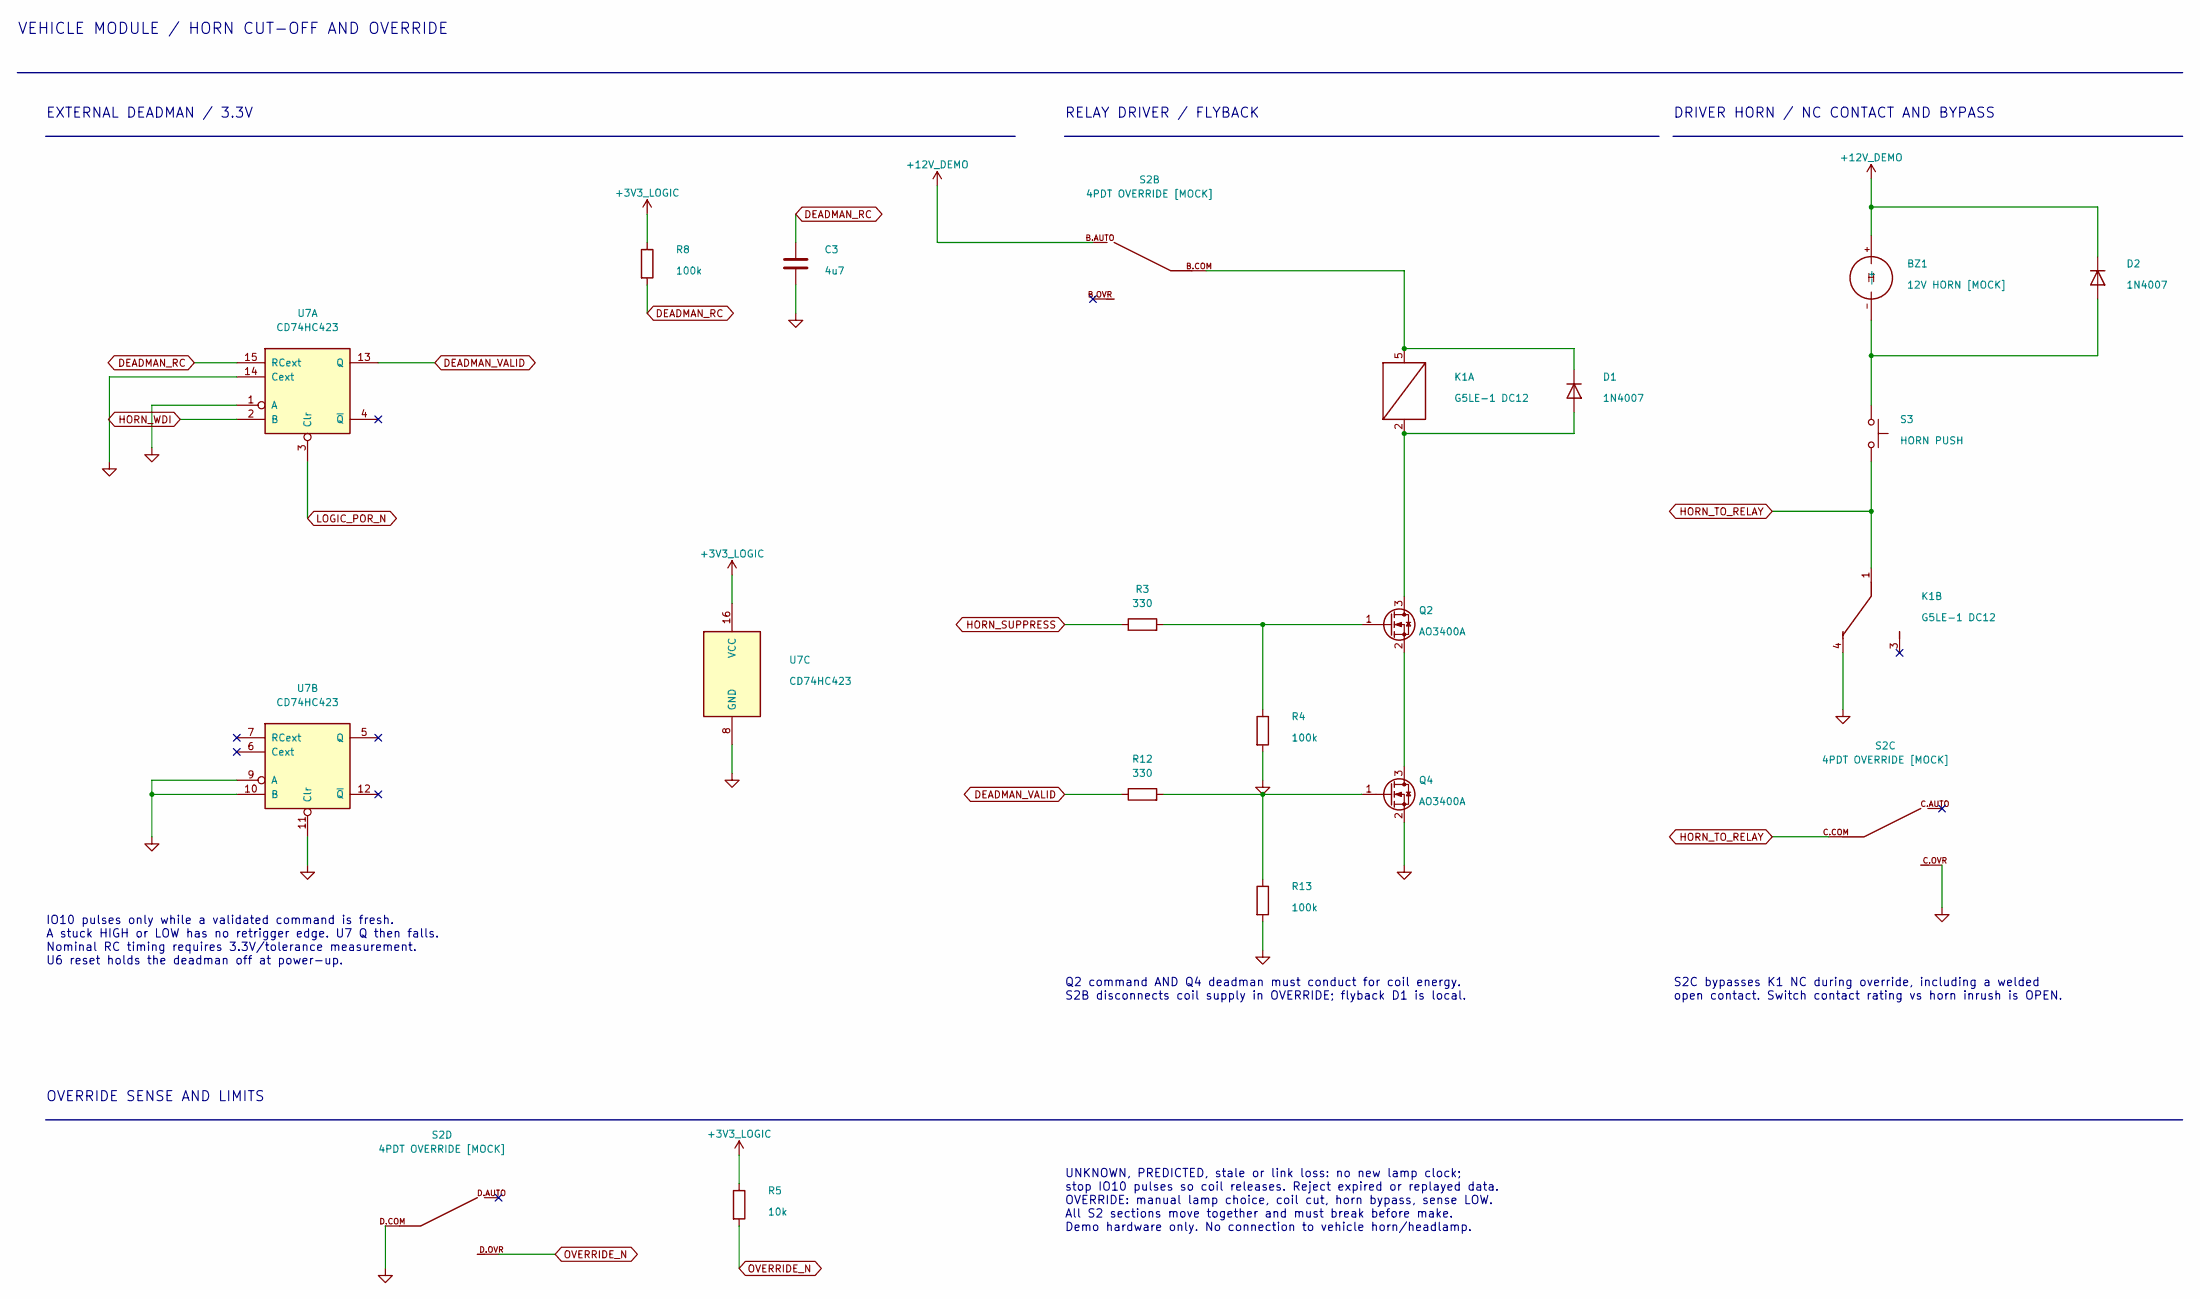
[picture p16: schematic Demo_Outputs_and_Override.kicad_sch]

Parts:
BZ1: 12V HORN [MOCK]
C3: 4u7
D1, D2: 1N4007
K1: G5LE-1 DC12; Relay_SPDT_Omron-G5LE-1
Q2, Q4: AO3400A; SOT-23
R3, R12: 330
R4, R8, R13: 100k
R5: 10k
S2: 4PDT OVERRIDE [MOCK]
S3: HORN PUSH
U7: CD74HC423

Connections:
+3V3_LOGIC: R5.1, R8.1, U7.16 (VCC)
+12V_DEMO: BZ1.+, D2.1 (K), S2.B.AUTO (AUTO)
DEADMAN_RC: C3.1, R8.2, U7.15 (RCext)
DEADMAN_VALID: R12.1, U7.13 (Q)
GND: C3.2, K1.4 (NC), Q4.2 (S), R4.2, R13.2, S2.C.OVR (OVERRIDE), S2.D.COM (COM), U7.1 (A), U7.8 (GND), U7.9 (A), U7.10 (B), U7.11 (Clr), U7.14 (Cext)
HORN_SUPPRESS: R3.1
HORN_TO_RELAY: K1.1 (COM), S2.C.COM (COM), S3.2
HORN_WDI: U7.2 (B)
LOGIC_POR_N: U7.3 (Clr)
unnamed: BZ1.-, D2.2 (A), S3.1
unnamed: D1.1 (K), K1.5 (COIL+), S2.B.COM (COM)
unnamed: D1.2 (A), K1.2 (COIL-), Q2.3 (D)
unnamed: Q2.1 (G), R3.2, R4.1
unnamed: Q2.2 (S), Q4.3 (D)
unnamed: Q4.1 (G), R12.2, R13.1
OVERRIDE_N: R5.2, S2.D.OVR (OVERRIDE)

Notes on the sheet:
VEHICLE MODULE / HORN CUT-OFF AND OVERRIDE
EXTERNAL DEADMAN / 3.3V
IO10 pulses only while a validated command is fresh. A stuck HIGH or LOW has no retrigger edge. U7 Q then falls. Nominal RC timing requires 3.3V/tolerance measurement. U6 reset holds the deadman off at power-up.
RELAY DRIVER / FLYBACK
Q2 command AND Q4 deadman must conduct for coil energy. S2B disconnects coil supply in OVERRIDE; flyback D1 is local.
DRIVER HORN / NC CONTACT AND BYPASS
S2C bypasses K1 NC during override, including a welded open contact. Switch contact rating vs horn inrush is OPEN.
OVERRIDE SENSE AND LIMITS
UNKNOWN, PREDICTED, stale or link loss: no new lamp clock; stop IO10 pulses so coil releases. Reject expired or replayed data. OVERRIDE: manual lamp choice, coil cut, horn bypass, sense LOW. All S2 sections move together and must break before make. Demo hardware only. No connection to vehicle horn/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
