mritunjaysharma450-cloud/VISHVAKARMA-AWARDS-VK26-IITH-SC-0177/Electronics Schematics & BOM/Vehicle Module Electronic Schematic/Lamp_Mode_and_Manual_Selection.kicad_sch

## KiCad design Electronics Schematics & BOM/Vehicle Module Electronic Schematic/Lamp_Mode_and_Manual_Selection.kicad_sch (2026-10-26)

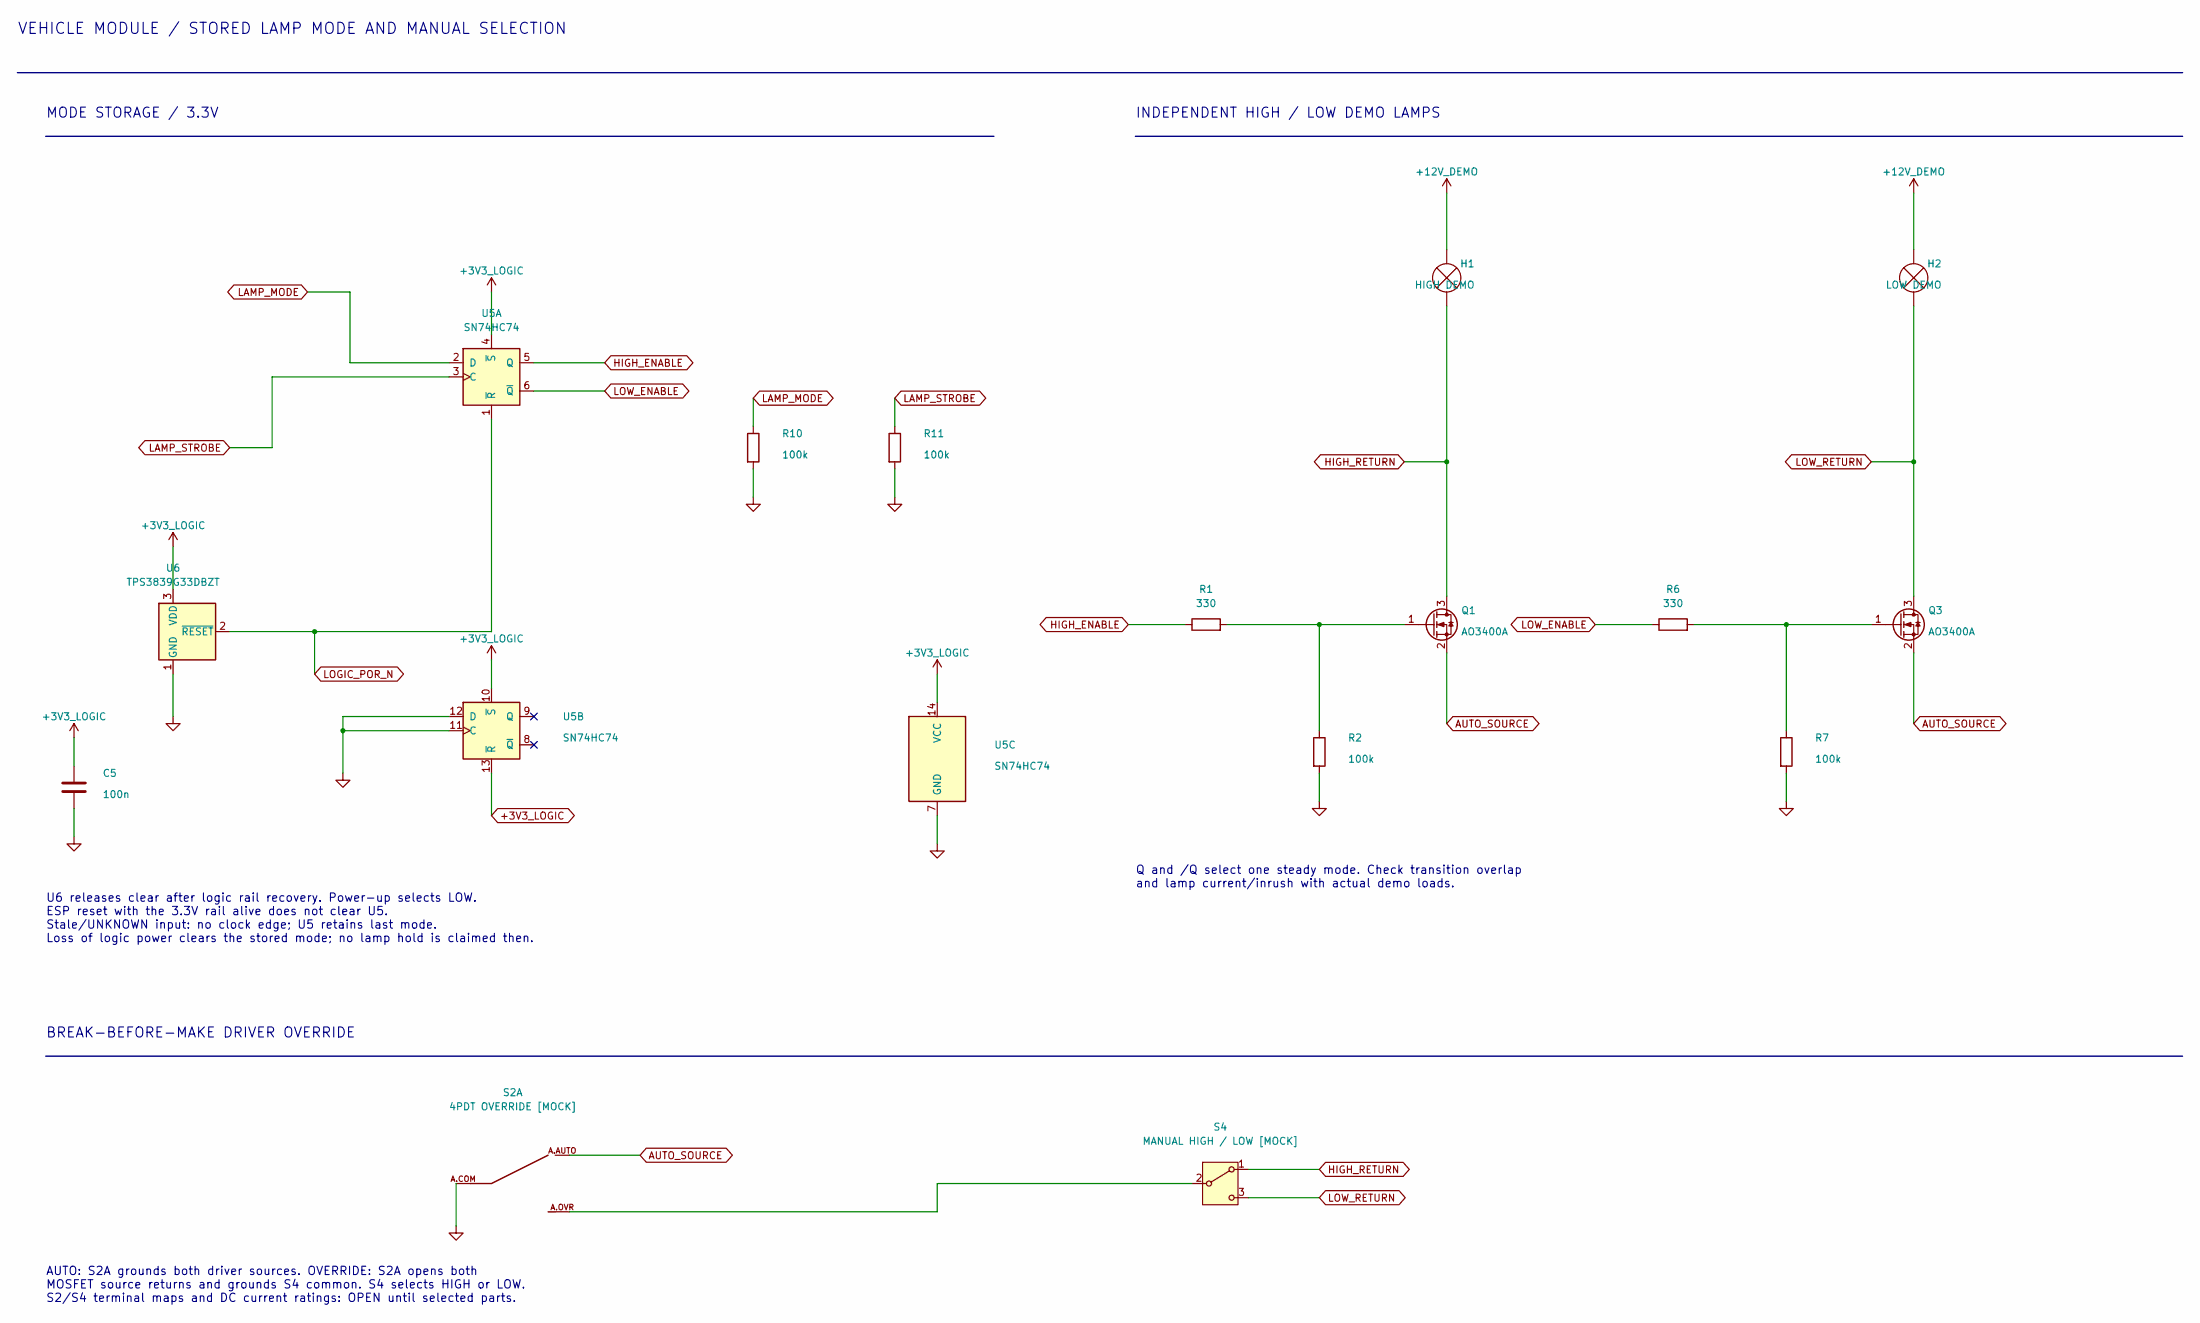
[picture p17: schematic Lamp_Mode_and_Manual_Selection.kicad_sch]

Parts:
C5: 100n
H1: HIGH DEMO
H2: LOW DEMO
Q1, Q3: AO3400A; SOT-23
R1, R6: 330
R2, R7, R10, R11: 100k
S2: 4PDT OVERRIDE [MOCK]
S4: MANUAL HIGH / LOW [MOCK]
U5: SN74HC74
U6: TPS3839G33DBZT; SOT-23

Connections:
+3V3_LOGIC: C5.1, U5.4 (~S), U5.10 (~S), U5.13 (~R), U5.14 (VCC), U6.3 (VDD)
+12V_DEMO: H1.1 (-), H2.1 (-)
AUTO_SOURCE: Q1.2 (S), Q3.2 (S), S2.A.AUTO (AUTO)
GND: C5.2, R2.2, R7.2, R10.2, R11.2, S2.A.COM (COM), U5.7 (GND), U5.11 (C), U5.12 (D), U6.1 (GND)
HIGH_ENABLE: R1.1, U5.5 (Q)
HIGH_RETURN: H1.2 (+), Q1.3 (D), S4.1 (A)
LAMP_MODE: R10.1, U5.2 (D)
LAMP_STROBE: R11.1, U5.3 (C)
LOGIC_POR_N: U5.1 (~R), U6.2 (~RESET)
LOW_ENABLE: R6.1, U5.6 (~Q)
LOW_RETURN: H2.2 (+), Q3.3 (D), S4.3 (C)
unnamed: Q1.1 (G), R1.2, R2.1
unnamed: Q3.1 (G), R6.2, R7.1
unnamed: S2.A.OVR (OVERRIDE), S4.2 (B)

Notes on the sheet:
VEHICLE MODULE / STORED LAMP MODE AND MANUAL SELECTION
MODE STORAGE / 3.3V
U6 releases clear after logic rail recovery. Power-up selects LOW. ESP reset with the 3.3V rail alive does not clear U5. Stale/UNKNOWN input: no clock edge; U5 retains last mode. Loss of logic power clears the stored mode; no lamp hold is claimed then.
INDEPENDENT HIGH / LOW DEMO LAMPS
Q and /Q select one steady mode. Check transition overlap and lamp current/inrush with actual demo loads.
BREAK-BEFORE-MAKE DRIVER OVERRIDE
AUTO: S2A grounds both driver sources. OVERRIDE: S2A opens both MOSFET source returns and grounds S4 common. S4 selects HIGH or LOW. S2/S4 terminal maps and DC current ratings: OPEN until selected parts.
