mritunjaysharma450-cloud/VISHVAKARMA-AWARDS-VK26-IITH-SC-0177/Electronics Schematics & BOM/Vehicle Module Electronic Schematic/Vehicle_Module_Electronic_Schematic.kicad_sch

## KiCad design Electronics Schematics & BOM/Vehicle Module Electronic Schematic/Vehicle_Module_Electronic_Schematic.kicad_sch (2026-10-26)

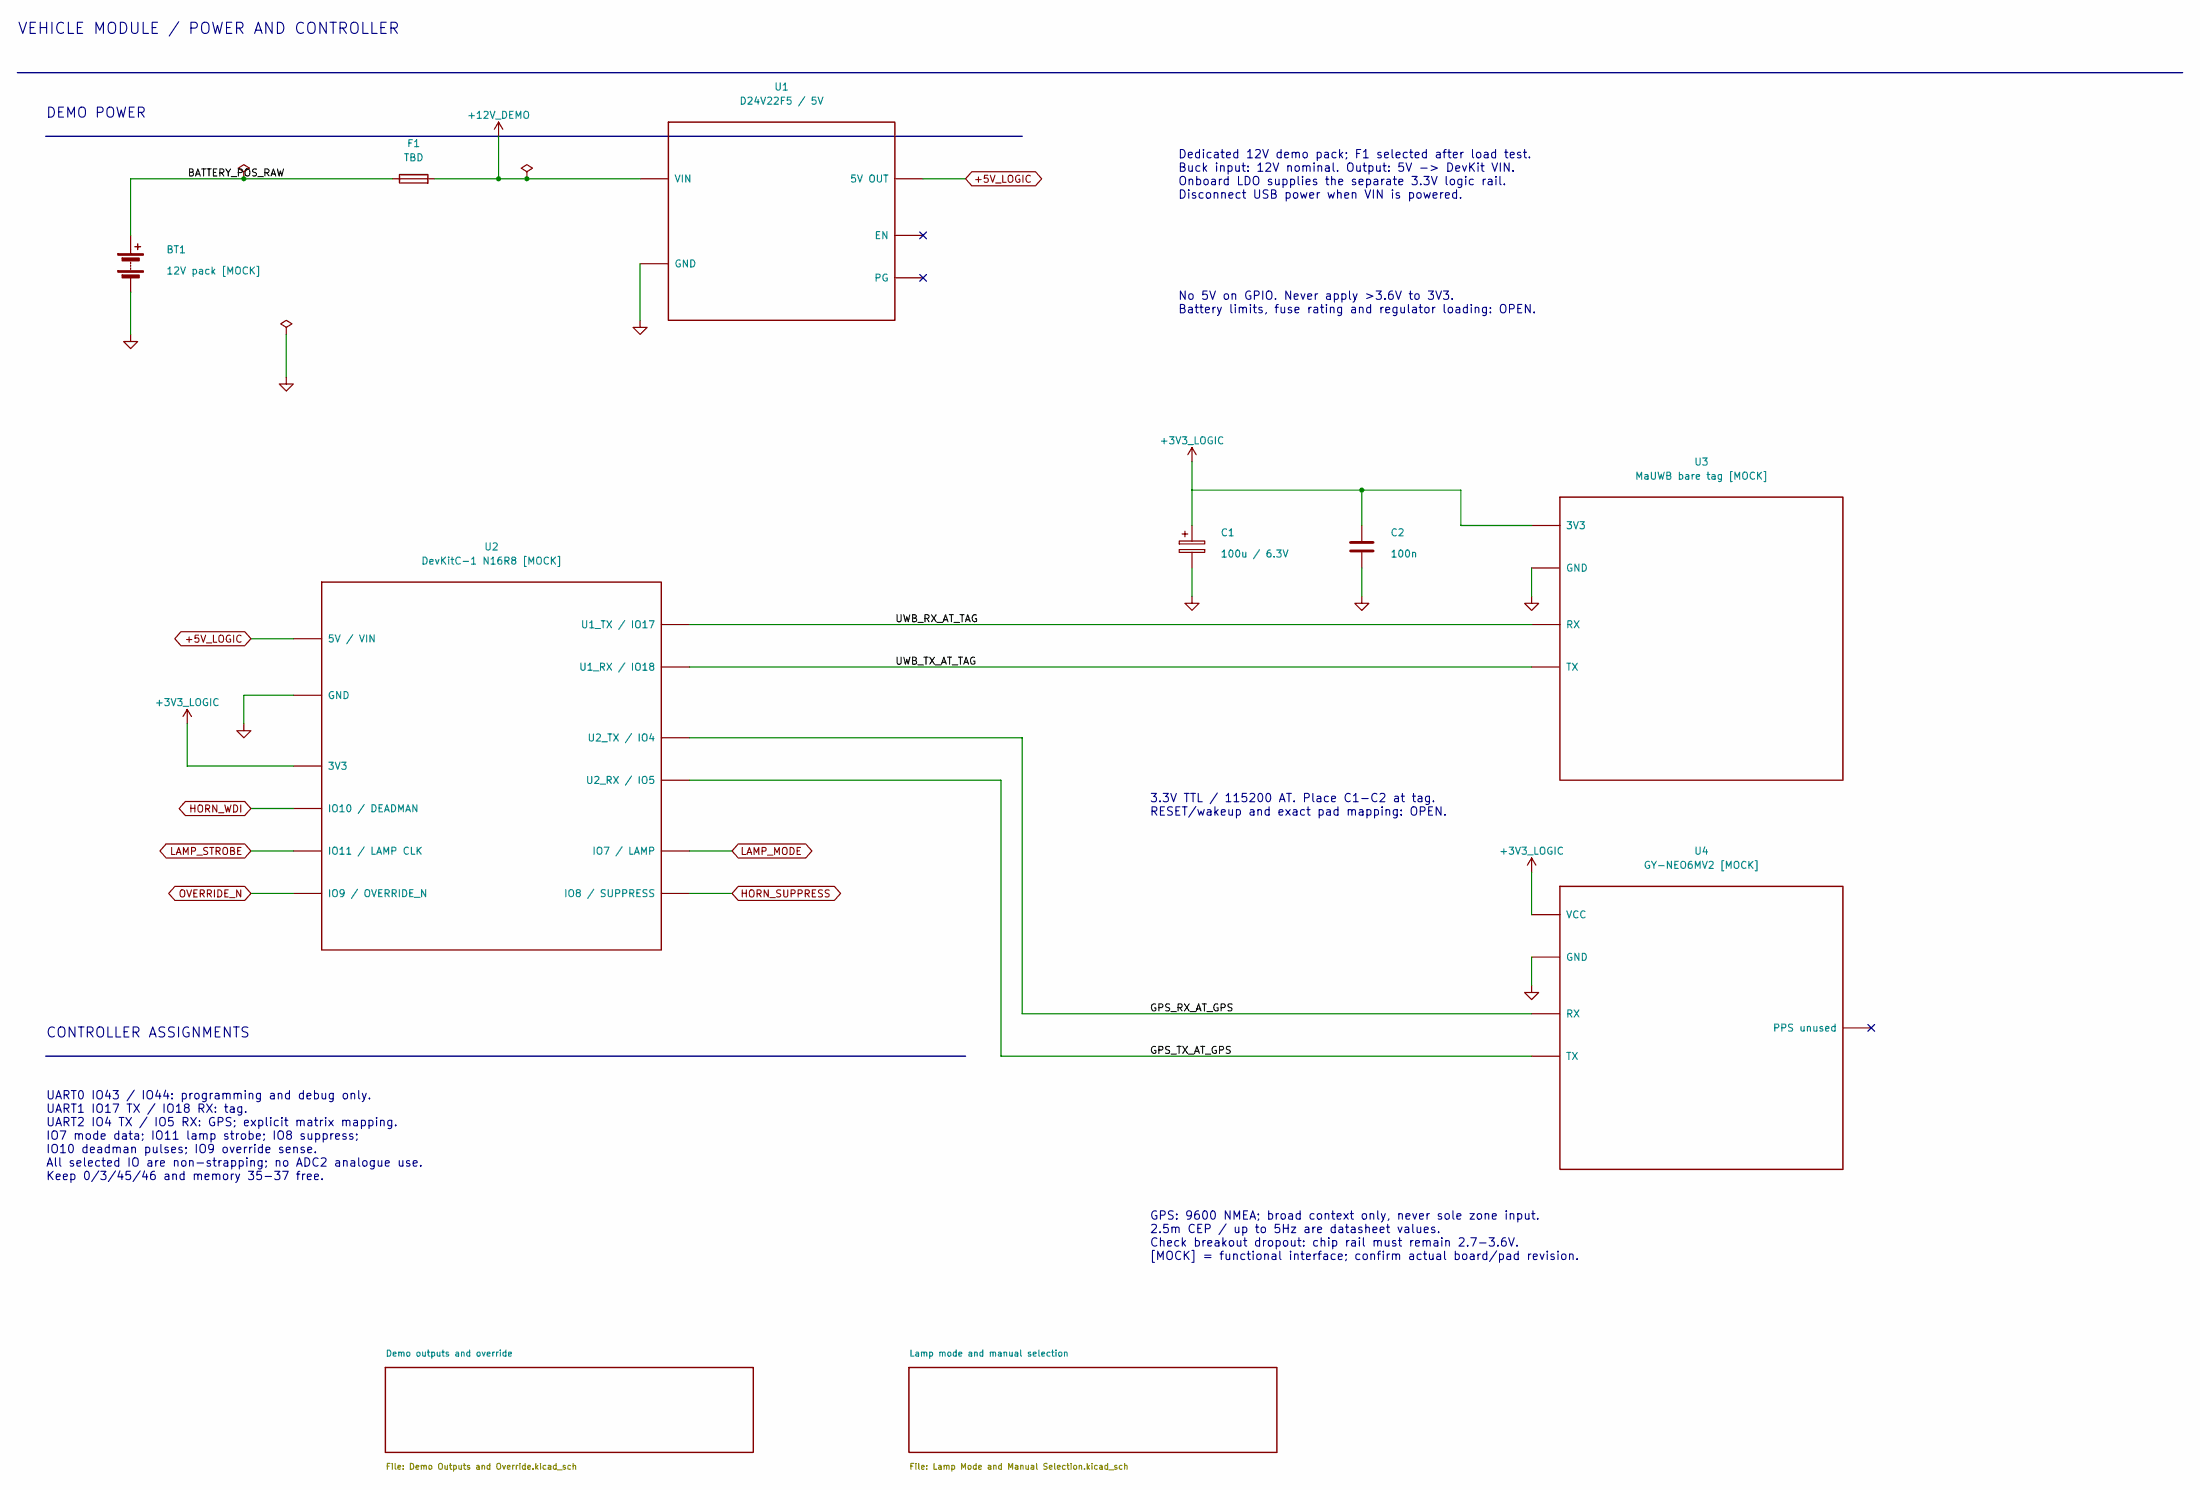
[picture p18: schematic Vehicle_Module_Electronic_Schematic.kicad_sch]

Parts:
BT1: 12V pack [MOCK]
C1: 100u / 6.3V
C2: 100n
F1: TBD
U1: D24V22F5 / 5V
U2: DevKitC-1 N16R8 [MOCK]
U3: MaUWB bare tag [MOCK]
U4: GY-NEO6MV2 [MOCK]

Connections:
+3V3_LOGIC: C1.1, C2.1, U2.3V3, U3.3V3, U4.VCC
+5V_LOGIC: U1.VOUT (5V OUT), U2.5V (5V / VIN)
+12V_DEMO: F1.2, U1.VIN
BATTERY_POS_RAW: BT1.+, F1.1
GND: BT1.-, C1.2, C2.2, U1.GND, U2.GND, U3.GND, U4.GND
GPS_RX_AT_GPS: U2.GPIO4 (U2_TX / IO4), U4.RX
GPS_TX_AT_GPS: U2.GPIO5 (U2_RX / IO5), U4.TX
HORN_SUPPRESS: U2.GPIO8 (IO8 / SUPPRESS)
HORN_WDI: U2.GPIO10 (IO10 / DEADMAN)
LAMP_MODE: U2.GPIO7 (IO7 / LAMP)
LAMP_STROBE: U2.GPIO11 (IO11 / LAMP CLK)
OVERRIDE_N: U2.GPIO9 (IO9 / OVERRIDE_N)
UWB_RX_AT_TAG: U2.GPIO17 (U1_TX / IO17), U3.RX
UWB_TX_AT_TAG: U2.GPIO18 (U1_RX / IO18), U3.TX

Notes on the sheet:
VEHICLE MODULE / POWER AND CONTROLLER
DEMO POWER
Dedicated 12V demo pack; F1 selected after load test. Buck input: 12V nominal. Output: 5V -> DevKit VIN. Onboard LDO supplies the separate 3.3V logic rail. Disconnect USB power when VIN is powered.
No 5V on GPIO. Never apply >3.6V to 3V3. Battery limits, fuse rating and regulator loading: OPEN.
3.3V TTL / 115200 AT. Place C1-C2 at tag. RESET/wakeup and exact pad mapping: OPEN.
CONTROLLER ASSIGNMENTS
UART0 IO43 / IO44: programming and debug only. UART1 IO17 TX / IO18 RX: tag. UART2 IO4 TX / IO5 RX: GPS; explicit matrix mapping. IO7 mode data; IO11 lamp strobe; IO8 suppress; IO10 deadman pulses; IO9 override sense. All selected IO are non-strapping; no ADC2 analogue use. Keep 0/3/45/46 and memor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
GPS: 9600 NMEA; broad context only, never sole zone input. 2.5m CEP / up to 5Hz are datasheet values. Check breakout dropout: chip rail must remain 2.7-3.6V. [MOCK] = functional interface; confirm actual board/pad revision.
