mritunjaysharma450-cloud/VISHVAKARMA-AWARDS-VK26-IITH-SC-0177/(commit log)

2026-10-26 Add pole schematic
    [Gate_and_Wireless.kicad_sch, Pole_Unit_Electronic_Schematic.kicad_sch]
2026-10-26 Add system architecture and CAD notes
2026-10-26 Add electronics schematics and BOM note
    [Demo_Outputs_and_Override.kicad_sch, Gate_and_Wireless.kicad_sch, Lamp_Mode_and_Manual_Selection.kicad_sch, Pole_Unit_Electronic_Schematic.kicad_sch, Vehicle_Module_Electronic_Schematic.kicad_sch]
2026-10-26 Rewrite overview, index, CAD, image sources, and maker journey for jury readers
2026-10-26 Rewrite system architecture, software, and schematic notes for jury readers
2026-10-26 Remove extra files from schematic folder, keep KiCad design only
2026-10-26 Remove duplicate and unnecessary files
    [Gate_and_Wireless.kicad_sch]
2026-10-27 Add Pole Unit Electronics and Data Flow.pdf for viewing
